whiteway11890/PIC32_Dev/README.md

# PIC32_Dev
PIC32 Development system created for Cornell University ECE 4760
