whiteway11890/PIC32_Dev/Documentation/MEng/Poster.pdf

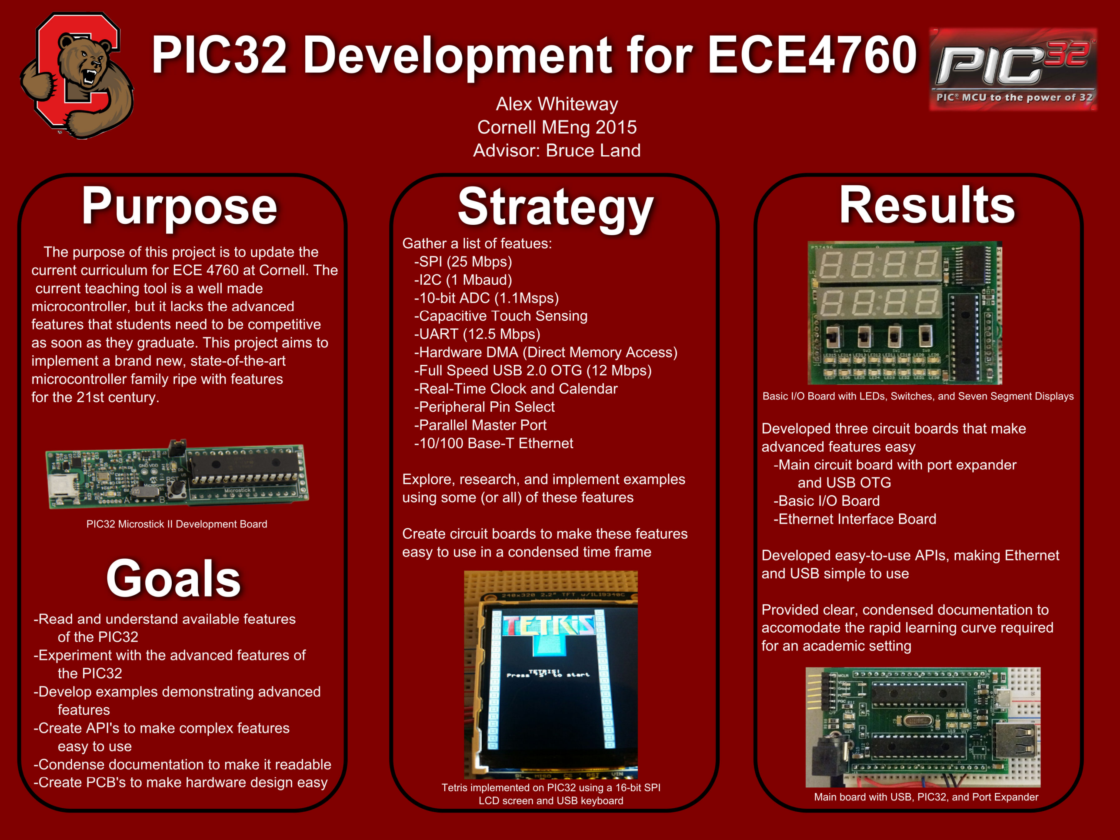
[picture p18: page 1]
