whiteway11890/PIC32_Dev/Hardware/BOM.xlsx

Part | Value | Package | Main | LED | Comm | Total | Mfr. # | Mfr | Digikey # | Digikey Link
7 Seg Display | Common Cath | DIP16 |  | 2 |  | 2 | LTC-4727JR | Lite-On | 160-1551-5-ND | http://www.digikey.com/product-detail/en/LTC-4727JR/160-1551-5-ND/408224
7 Seg Driver |  | SO24W |  | 1 |  | 1 | MAX7219CWG+T | Maxim | MAX7219CWG+TTR-ND | http://www.digikey.com/product-detail/en/MAX7219CWG%2BT/MAX7219CWG%2BTTR-ND/1514450
Barrel Plug |  | 2.1MM | 1 |  |  | 1 | RAPC722X | Switchcraft | SC1313-ND | http://www.digikey.com/product-search/en?x=0&y=0&lang=en&site=us&keywords=RAPC722X
Buckboost Conv |  | SOT-23-6 | 1 |  |  | 1 | AP1603WG-7 | Diodes Inc | AP1603WG-7DI-ND | http://www.digikey.com/product-search/en?KeyWords=AP1603WG&WT.z_header=search_go
Capacitor | 0.01uF | 1206 |  |  | 2 | 2 | CL31B103KBCNNNC | Samsung | 1276-1035-1-ND | http://www.digikey.com/product-detail/en/CL31B103KBCNNNC/1276-1035-1-ND/3889121
Capacitor | 0.1uF | 1206 | 1 | 1 |  | 2 | CL31B104KBCNNNC | Samsung | 1276-1017-1-ND | http://www.digikey.com/product-detail/en/CL31B104KBCNNNC/1276-1017-1-ND/3889103
Capacitor | 10uF | 1206 | 7 |  | 1 | 8 | CL31A106KPHNNNE | Samsung | 1276-1148-1-ND | http://www.digikey.com/product-detail/en/CL31A106KPHNNNE/1276-1148-1-ND/3889234
Capacitor | 18nF | 1206 | 2 |  | 2 | 4 | CC1206KRX7R9BB183 | Yageo | 311-1202-1-ND | http://www.digikey.com/product-detail/en/CC1206KRX7R9BB183/311-1202-1-ND/372915
Capacitor | 1uF | 1206 | 1 |  |  | 1 | CL31B105KOFNNNE | Samsung | 1276-1783-1-ND | http://www.digikey.com/product-detail/en/CL31B105KOFNNNE/1276-1783-1-ND/3889869
Capacitor | 47nF | 1206 | 1 | 1 |  | 2 | CL31B473KEHNNNE | Samsung | 1276-3172-1-ND | http://www.digikey.com/product-detail/en/CL31B473KEHNNNE/1276-3172-1-ND/3891258
Capacitor | 47uF | 1206 | 2 |  |  | 2 | CL31A476MQHNNNE | Samsung | 1276-1167-6-ND | http://www.digikey.com/product-detail/en/CL31A476MQHNNNE/1276-1167-6-ND/3891681
Capacitor | 6.8nF | 1206 |  |  | 2 | 2 | CL31B682KBCNNNC | Samsung | 1276-1775-1-ND | http://www.digikey.com/product-detail/en/CL31B682KBCNNNC/1276-1775-1-ND/3889861
Capacitor | 6.8uF | 1206 | 1 |  |  | 1 | C3216X6S1A685K085AB | TDK | 445-14757-1-ND | http://www.digikey.com/product-detail/en/C3216X6S1A685K085AB/445-14757-1-ND/3956423
Crystal | 25MHz | HC-49US |  |  | 1 | 1 | ABL-25.000MHZ-B2 | Abracon | CTX928-ND | http://www.digikey.com/product-detail/en/ATS250B-E/CTX928-ND/2292924
Crystal | 8MHz | HC-49US | 1 |  |  | 1 | ABL-8.000MHZ-B2 | Abracon | CTX900-ND | http://www.digikey.com/product-detail/en/ATS080B/CTX900-ND/2292868
Diode | Schottky 50v | SOD-123 | 1 |  |  | 1 | B0530W-7-F | Diodes Inc | B0530W-FDICT-ND | http://www.digikey.com/product-detail/en/B0530W-7-F/B0530W-FDICT-ND/815315
Eth Conn | Magjack | ZIP8 |  |  | 1 | 1 | ARJC02-111009D | Abracon | Sparkfun PRT-08534 | https://www.sparkfun.com/products/8534
Header | 1x2 | SIP2 | 2 |  |  | 2 | 961102-6404-AR | 3M | 3M9447-ND | http://www.digikey.com/product-detail/en/961102-6404-AR/3M9447-ND/2071488
Header | 1x20 | SIP20 | 2 |  |  | 2 | PRPC020SAAN-RC | Sullins | S1011EC-20-ND | http://www.digikey.com/product-detail/en/PRPC020SAAN-RC/S1011EC-20-ND/2775234
Header | 1x6 | SIP6 | 1 |  |  | 1 | 961106-5604-AR | 3M | 3M9471-ND | http://www.digikey.com/product-detail/en/961106-5604-AR/3M9471-ND/2071512
Header | 1x8 | SIP8 |  | 2 | 2 | 4 | PRPC008SFAN-RC | Sullins | S1211EC-08-ND | http://www.digikey.com/product-detail/en/PRPC008SFAN-RC/S1211EC-08-ND/2775366
Inductor | 22uH | 1206 | 1 |  |  | 1 | LQH31CN220K03L | Murata | 490-6591-1-ND | http://www.digikey.com/product-detail/en/LQH31CN220K03L/490-6591-1-ND/3845788
LED | Any color | 1206 | 6 | 17 | 1 | 24 | APTR3216SGC | Kingbright | 754-1171-1-ND | http://www.digikey.com/product-detail/en/APTR3216SGC/754-1171-1-ND/1747888
PHY/MAC |  | DIP28 |  |  | 1 | 1 | ENC28J60-I/SP | Microchip | ENC28J60-I/SP-ND | http://www.digikey.com/product-search/en?pv1291=6302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
PIC32 | MX250F128B | DIP28 | 1 |  |  | 1 | PIC32MX250F128B-50I/SP | Microchip | PIC32MX250F128B-50I/SP-ND | http://www.digikey.com/product-detail/en/PIC32MX250F128B-50I%2FSP/PIC32MX250F128B-50I%2FSP-ND/3872973
Port Exp. | MAX6957 | DIP28 | 1 | 1 |  | 2 | MAX6957ANI+ | Maxim | MAX6957ANI+-ND | http://www.digikey.com/product-detail/en/MAX6957ANI%2B/MAX6957ANI%2B-ND/950811
Power Reg | 3.3V | SOT-223 | 1 |  |  | 1 | AZ1117EH-3.3TRG1 | Diodes Inc | AZ1117EH-3.3TRG1DICT-ND | http://www.digikey.com/product-detail/en/AZ1117EH-3.3TRG1/AZ1117EH-3.3TRG1DICT-ND/5001336
Power Reg | 5V | SOT-223 | 1 |  |  | 1 | AZ1117EH-5.0TRG1 | Diodes Inc | AZ1117EH-5.0TRG1DICT-ND | http://www.digikey.com/product-detail/en/AZ1117EH-5.0TRG1/AZ1117EH-5.0TRG1DICT-ND/5001335
Resistor | 0Ω | 1206 | 2 | 3 |  | 5 | RC3216J000CS | Samsung | 1276-3514-1-ND | http://www.digikey.com/product-detail/en/RC3216J000CS/1276-3514-1-ND/3903617
Resistor | 100kΩ | 1206 | 1 |  |  | 1 | RC3216F104CS | Samsung | 1276-5781-1-ND | http://www.digikey.com/product-detail/en/RC3216F104CS/1276-5781-1-ND/3968753
Resistor | 10kΩ | 1206 |  | 1 | 1 | 2 | RC3216F103CS | Samsung | 1276-5742-1-ND | http://www.digikey.com/product-detail/en/RC3216F103CS/1276-5742-1-ND/3968714
Resistor | 10Ω | 1206 |  |  | 1 | 1 | RC3216F100CS | Samsung | 1276-3513-2-ND | http://www.digikey.com/product-detail/en/RC3216F100CS/1276-3513-2-ND/3903521
Resistor | 180Ω | 1206 |  |  | 1 | 1 | RC3216F181CS | Samsung | 1276-5679-1-ND | http://www.digikey.com/product-detail/en/RC3216F181CS/1276-5679-1-ND/3968651
Resistor | 1kΩ | 1206 | 2 | 1 | 1 | 4 | RC3216F102CS | Samsung | 1276-5711-1-ND | http://www.digikey.com/product-detail/en/RC3216F102CS/1276-5711-1-ND/3968683
Resistor | 2.7kΩ | 1206 |  |  | 1 | 1 | RC3216F272CS | Samsung | 1276-5725-2-ND | http://www.digikey.com/product-detail/en/RC3216F272CS/1276-5725-2-ND/3966032
Resistor | 330Ω | 1206 | 2 |  | 1 | 3 | RC3216F331CS | Samsung | 1276-5690-1-ND | http://www.digikey.com/product-detail/en/RC3216F331CS/1276-5690-1-ND/3968662
Resistor | 39kΩ | 1206 | 1 | 1 |  | 2 | RC1206FR-0739KL | Yageo | 311-39.0KFRCT-ND | http://www.digikey.com/product-detail/en/RC1206FR-0739KL/311-39.0KFRCT-ND/731802
Resistor | 49.9Ω | 1206 |  |  | 4 | 4 | RC1206FR-0749R9L | Yageo | 311-49.9FRCT-ND | http://www.digikey.com/product-detail/en/RC1206FR-0749R9L/311-49.9FRCT-ND/731889
Switches | Off-Mom SPST | 6.2mmx6.2mm | 1 |  |  | 1 | KSC741G LFS | C&K | CKN10305CT-ND | http://www.digikey.com/product-detail/en/KSC741G%20LFS/CKN10305CT-ND/2415036
Switches | On-Off Slide |  |  | 4 |  | 4 | OS102011MS2QN1 | C&K | CKN9565-ND | http://www.digikey.com/product-detail/en/OS102011MS2QN1/CKN9565-ND/411602
USB Pwr Sw. |  | SOIC-8 | 1 |  |  | 1 | MCP1253-33X50I/MS | Microchip | MCP1253-33X50I/MS | http://www.digikey.com/product-detail/en/MCP1253-33X50I%2FMS/MCP1253-33X50I%2FMS-ND/529833
USB-A |  | USB | 1 |  |  | 1 | UE27AC5410H | Amphenol | UE27AC5410H-ND | http://www.digikey.com/product-search/en?vendor=0&keywords=UE27AC5410H
USB-AB |  | Micro | 1 |  |  | 1 | 798-ZX62-AB-5PA11 | Hirose | H11635CT-ND | http://www.digikey.com/product-detail/en/ZX62-AB-5PA(11)/H11635CT-ND/1993370
WallWart | 5V |  | 1 |  |  | 1 | WSU060-1250 | Triad | 237-1421-ND | http://www.digikey.com/product-detail/en/WSU060-1250/237-1421-ND/3094947
