whiteway11890/PIC32_Dev/(list of files, drawings)

Other design files:
Hardware/Schematics/Communications.ms11
Hardware/Schematics/LEDs.ms11
Hardware/Schematics/Main.ms11
