whiteway11890/PIC32_Dev/Firmware/Ethernet/src/TCP.c

/*********************************************************************
 *
 *	Transmission Control Protocol (TCP) Communications Layer
 *  Module for Microchip TCP/IP Stack
 *	 -Provides reliable, handshaked transport of application stream 
 *    oriented data with flow control
 *	 -Reference: RFC 793
 *
 *********************************************************************
 * FileName:        TCP.c
 * Dependencies:    IP, Tick, Ethernet/WiFi (ENC28J60.c, ETH97J60.c, 
 *					ENCX24J600.c, or WFMac.c), ARP (optional), 
 *					DNS (optional)
 * Processor:       PIC18, PIC24F, PIC24H, dsPIC30F, dsPIC33F, PIC32
 * Compiler:        Microchip C32 v1.05 or higher
 *					Microchip C30 v3.12 or higher
 *					Microchip C18 v3.30 or higher
 *					HI-TECH PICC-18 PRO 9.63PL2 or higher
 * Company:         Microchip Technology, Inc.
 *
 * Software License Agreement
 *
 * Copyright (C) 2002-2009 Microchip Technology Inc.  All rights
 * reserved.
 *
 * Microchip licenses to you the right to use, modify, copy, and
 * distribute:
 * (i)  the Software when embedded on a Microchip microcontroller or
 *      digital signal controller product ("Device") which is
 *      integrated into Licensee's product; or
 * (ii) ONLY the Software driver source files ENC28J60.c, ENC28J60.h,
 *		ENCX24J600.c and ENCX24J600.h ported to a non-Microchip device
 *		used in conjunction with a Microchip ethernet controller for
 *		the sole purpose of interfacing with the ethernet controller.
 *
 * You should refer to the license agreement accompanying this
 * Software for additional information regarding your rights and
 * obligations.
 *
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
 *
 * Author               Date    	Comment
 *~~~~~~~~~~~~~~~~~~~~~~~~~~~~~~~~~~~~~~~~~~~~~~~~~~~~~~~~~~~~~~~~~~~~
 * Nilesh Rajbharti     5/8/01  	Original        (Rev 1.0)
 * Howard Schlunder		12/11/06	Changed almost everything to 
 *									better meet RFC 793.
 ********************************************************************/
#define __TCP_C

#include "GenericTypeDefs.h"
#include "TCPIP.h"

int tcpLoc = 0;

#if defined(STACK_USE_TCP)

/****************************************************************************
  Section:
        Configuration Parameters
 ***************************************************************************/

// Starting port for client sockets
#define LOCAL_PORT_START_NUMBER (1024u)
// End port for client sockets
#define LOCAL_PORT_END_NUMBER   (5000u)

// For debugging only.  Normal applications should never enable these
//#define DEBUG_GENERATE_TX_LOSS		62257
//#define DEBUG_GENERATE_RX_LOSS		64225

// A lot of pointer dereference code can be removed if you 
// locally copy TCBStubs to an absolute memory location.
// If you define TCP_OPTIMIZE_FOR_SIZE, local caching will 
// occur and will substantially decrease the entire TCP ROM 
// footprint (up to 35%).  If you leave TCP_OPTIMIZE_FOR_SIZE 
// undefined, the local caching will be disabled.  On PIC18 
// products, this will improve TCP performance/throughput by 
// approximately 15%.
#define TCP_OPTIMIZE_FOR_SIZE

// For smallest size and best throughput, TCP_OPTIMIZE_FOR_SIZE 
// should always be enabled on PIC24/dsPIC products.  On PIC32 
// products there is very little difference and depnds on compiler 
// optimization level
#if defined(__C30__) && !defined(TCP_OPTIMIZE_FOR_SIZE)
#define TCP_OPTIMIZE_FOR_SIZE
#elif defined(__C32__) && defined(TCP_OPTIMIZE_FOR_SIZE)
#undef TCP_OPTIMIZE_FOR_SIZE
#endif

// TCP Maximum Segment Size for TX.  The TX maximum segment size is actually 
// govered by the remote node's MSS option advirtised during connection 
// establishment.  However, if the remote node specifies an unhandlably large 
// MSS (ex: > Ethernet MTU), this define sets a hard limit so that we don't 
// cause any TX buffer overflows.  If the remote node does not advirtise a MSS 
// option, all TX segments are fixed at 536 bytes maximum.
#define TCP_MAX_SEG_SIZE_TX			(1460u)

// TCP Maximum Segment Size for RX.  This value is advirtised during connection 
// establishment and the remote node should obey it.  This should be set to 536 
// to avoid IP layer fragmentation from causing packet loss.  However, raising 
// its value can enhance performance at the (small) risk of introducing 
// incompatibility with certain special remote nodes (ex: ones connected via a 
// slow dial up modem).
#define TCP_MAX_SEG_SIZE_RX			(536u)

// TCP Timeout and retransmit numbers
#define TCP_START_TIMEOUT_VAL   	((DWORD)TICK_SECOND*1)	// Timeout to retransmit unacked data
#define TCP_DELAYED_ACK_TIMEOUT		((DWORD)TICK_SECOND/10)	// Timeout for delayed-acknowledgement algorithm
#define TCP_FIN_WAIT_2_TIMEOUT		((DWORD)TICK_SECOND*5)	// Timeout for FIN WAIT 2 state
#define TCP_KEEP_ALIVE_TIMEOUT		((DWORD)TICK_SECOND*10)	// Timeout for keep-alive messages when no traffic is sent
#define TCP_CLOSE_WAIT_TIMEOUT		((DWORD)TICK_SECOND/5)	// Timeout for the CLOSE_WAIT state
#define TCP_MAX_RETRIES			    (5u)					// Maximum number of retransmission attempts
#define TCP_MAX_UNACKED_KEEP_ALIVES	(6u)					// Maximum number of keep-alive messages that can be sent without receiving a response before automatically closing the connection
#define TCP_MAX_SYN_RETRIES			(2u)	// Smaller than all other retries to reduce SYN flood DoS duration

#define TCP_AUTO_TRANSMIT_TIMEOUT_VAL	(TICK_SECOND/25ull)	// Timeout before automatically transmitting unflushed data
#define TCP_WINDOW_UPDATE_TIMEOUT_VAL	(TICK_SECOND/5ull)	// Timeout before automatically transmitting a window update due to a TCPGet() or TCPGetArray() function call

#define TCP_SYN_QUEUE_MAX_ENTRIES	(3u) 					// Number of TCP RX SYN packets to save if they cannot be serviced immediately
#define TCP_SYN_QUEUE_TIMEOUT		((DWORD)TICK_SECOND*3)	// Timeout for when SYN queue entries are deleted if unserviceable

/****************************************************************************
  Section:
        TCP Header Data Types
 ***************************************************************************/

#define FIN     (0x01)		// FIN Flag as defined in RFC
#define SYN     (0x02)		// SYN Flag as defined in RFC
#define RST     (0x04)		// Reset Flag as defined in RFC
#define PSH     (0x08)		// Push Flag as defined in RFC
#define ACK     (0x10)		// Acknowledge Flag as defined in RFC
#define URG     (0x20)		// Urgent Flag as defined in RFC

// TCP Header Data Structure

typedef struct {
    WORD SourcePort; // Local port number
    WORD DestPort; // Remote port number
    DWORD SeqNumber; // Local sequence number
    DWORD AckNumber; // Acknowledging remote sequence number

    struct {
        unsigned char Reserved3 : 4;
        unsigned char Val : 4;
    } DataOffset; // Data offset flags nibble

    union {

        struct {
            unsigned char flagFIN : 1;
            unsigned char flagSYN : 1;
            unsigned char flagRST : 1;
            unsigned char flagPSH : 1;
            unsigned char flagACK : 1;
            unsigned char flagURG : 1;
            unsigned char Reserved2 : 2;
        } bits;
        BYTE byte;
    } Flags; // TCP Flags as defined in RFC

    WORD Window; // Local free RX buffer window
    WORD Checksum; // Data payload checksum
    WORD UrgentPointer; // Urgent pointer
} TCP_HEADER;

#define TCP_OPTIONS_END_OF_LIST     (0x00u)		// End of List TCP Option Flag
#define TCP_OPTIONS_NO_OP           (0x01u)		// No Op TCP Option
#define TCP_OPTIONS_MAX_SEG_SIZE    (0x02u)		// Maximum segment size TCP flag

typedef struct {
    BYTE Kind; // Type of option
    BYTE Length; // Length
    WORD_VAL MaxSegSize; // Maximum segment size
} TCP_OPTIONS; // TCP Options data structure

// Structure containing all the important elements of an incomming 
// SYN packet in order to establish a connection at a future time 
// if all sockets on the listening port are already connected to 
// someone

typedef struct {
    NODE_INFO niSourceAddress; // Remote IP address and MAC address
    WORD wSourcePort; // Remote TCP port number that the response SYN needs to be sent to
    DWORD dwSourceSEQ; // Remote TCP SEQuence number that must be ACKnowledged when we send our response SYN
    WORD wDestPort; // Local TCP port which the original SYN was destined for
    WORD wTimestamp; // Timer to expire old SYN packets that can't be serviced at all
} TCP_SYN_QUEUE;


#if defined(STACK_CLIENT_MODE)
static WORD NextPort __attribute__((persistent)); // Tracking variable for next local client port number
#endif

/****************************************************************************
  Section:
        TCB Definitions
 ***************************************************************************/

// Determines the number of defined TCP sockets
#define TCP_SOCKET_COUNT	(sizeof(TCPSocketInitializer)/sizeof(TCPSocketInitializer[0]))


#if defined(HI_TECH_C)
// The initializer forces this large array out of the bss section 
// so we can link correctly.
#pragma psect bigdata=TCB_uRAM_BIG
#pragma psect data=TCB_uRAM
static TCB_STUB TCBStubs[TCP_SOCKET_COUNT] = {'\0'};
#pragma psect data=ordinary_data_sect
#pragma psect bigdata=ordinary_data_sect_big
#else
// The TCB array is very large.  With the C18 compiler, one must 
// modify the linker script to make an array that spans more than 
// one memory bank.  To do this, make the necessary changes to your 
// processor's linker script (.lkr).  Here is an example showing 
// gpr11 and 128 bytes of gpr12 being combined into one 384 byte 
// block used exclusively by the TCB_uRAM data section:
// ...
// //DATABANK   NAME=gpr11      START=0xB00          END=0xBFF
// //DATABANK   NAME=gpr12      START=0xC00          END=0xCFF
// DATABANK   NAME=gpr11b     START=0xB00          END=0xC7F           PROTECTED
// DATABANK   NAME=gpr12      START=0xC80          END=0xCFF
// ...
// SECTION    NAME=TCB_uRAM    RAM=gpr11b
// ...
#if defined(__18CXX) && !defined(HI_TECH_C)	
#pragma udata TCB_uRAM
#endif
static TCB_STUB TCBStubs[TCP_SOCKET_COUNT];
#if defined(__18CXX) && !defined(HI_TECH_C)	
#pragma udata					// Return to any other RAM section
#endif
#endif

static TCB MyTCB; // Currently loaded TCB
static TCP_SOCKET hCurrentTCP = INVALID_SOCKET; // Current TCP socket
#if TCP_SYN_QUEUE_MAX_ENTRIES
#if defined(__18CXX) && !defined(HI_TECH_C)	
#pragma udata SYN_QUEUE_RAM_SECT
#endif
static TCP_SYN_QUEUE SYNQueue[TCP_SYN_QUEUE_MAX_ENTRIES]; // Array of saved incoming SYN requests that need to be serviced later
#if defined(__18CXX) && !defined(HI_TECH_C)	
#pragma udata
#endif
#endif

/****************************************************************************
  Section:
        Function Prototypes
 ***************************************************************************/

static void TCPRAMCopy(PTR_BASE wDest, BYTE vDestType, PTR_BASE wSource, BYTE vSourceType, WORD wLength);

#if defined(__18CXX)
static void TCPRAMCopyROM(PTR_BASE wDest, BYTE wDestType, ROM BYTE* wSource, WORD wLength);
#else
#define TCPRAMCopyROM(a,b,c,d)	TCPRAMCopy(a,b,c,TCP_PIC_RAM,d)
#endif

static void SendTCP(BYTE vTCPFlags, BYTE vSendFlags);
static void HandleTCPSeg(TCP_HEADER* h, WORD len);
static BOOL FindMatchingSocket(TCP_HEADER* h, NODE_INFO* remote);
static void SwapTCPHeader(TCP_HEADER* header);
static void CloseSocket(void);
static void SyncTCB(void);

// Indicates if this packet is a retransmission (no reset) or a new packet (reset required)
#define SENDTCP_RESET_TIMERS	0x01
// Instead of transmitting normal data, a garbage octet is transmitted according to RFC 1122 section 4.2.3.6
#define SENDTCP_KEEP_ALIVE		0x02


/****************************************************************************
  Section:
        TCB Optimization Configuration
 ***************************************************************************/

#if defined(TCP_OPTIMIZE_FOR_SIZE)
static TCB_STUB MyTCBStub;

// Flushes MyTCBStub cache and loads up the specified TCB_STUB.
// Does nothing on cache hit.

static void SyncTCBStub(TCP_SOCKET hTCP) {
    if (hCurrentTCP == hTCP)
        return;

    if (hCurrentTCP != INVALID_SOCKET) {
        // Save the current TCB stub
        memcpy((void*) &TCBStubs[hCurrentTCP], (void*) &MyTCBStub, sizeof (MyTCBStub));
    }

    hCurrentTCP = hTCP;

    if (hTCP == INVALID_SOCKET)
        return;

    // Load up the new TCB stub
    memcpy((void*) &MyTCBStub, (void*) &TCBStubs[hTCP], sizeof (MyTCBStub));
}
#else
// Flushes MyTCBStub cache and loads up the specified TCB_STUB.
// Does nothing on cache hit.
#define SyncTCBStub(a)	hCurrentTCP = (a)
// Alias to current TCP stub.
#define MyTCBStub		TCBStubs[hCurrentTCP]
#endif



// Flushes MyTCB cache and loads up the specified TCB.
// Does nothing on cache hit.

static void SyncTCB(void) {
    static TCP_SOCKET hLastTCB = INVALID_SOCKET;

    if (hLastTCB == hCurrentTCP)
        return;

    if (hLastTCB != INVALID_SOCKET) {
        // Save the current TCB
        TCPRAMCopy(TCBStubs[hLastTCB].bufferTxStart - sizeof (MyTCB), TCBStubs[hLastTCB].vMemoryMedium, (PTR_BASE) & MyTCB, TCP_PIC_RAM, sizeof (MyTCB));
    }

    // Load up the new TCB
    hLastTCB = hCurrentTCP;
    TCPRAMCopy((PTR_BASE) & MyTCB, TCP_PIC_RAM, MyTCBStub.bufferTxStart - sizeof (MyTCB), MyTCBStub.vMemoryMedium, sizeof (MyTCB));
}

/*****************************************************************************
  Function:
        void TCPInit(void)

  Summary:
        Initializes the TCP module.

  Description:
        Initializes the TCP module.  This function sets up the TCP buffers
        in memory and initializes each socket to the CLOSED state.  If
        insufficient memory was allocated for the TCP sockets, the function
        will hang here to be captured by the debugger.

  Precondition:
        None

  Parameters:
        None

  Returns:
        None
  	
  Remarks:
        This function is called only one during lifetime of the application.
 ***************************************************************************/
void TCPInit(void) {
    BYTE i;
    BYTE vSocketsAllocated;
    WORD wTXSize, wRXSize;
    PTR_BASE ptrBaseAddress;
    BYTE vMedium;
#if TCP_ETH_RAM_SIZE > 0
    WORD wCurrentETHAddress = TCP_ETH_RAM_BASE_ADDRESS;
#endif
#if TCP_PIC_RAM_SIZE > 0
    PTR_BASE ptrCurrentPICAddress = TCP_PIC_RAM_BASE_ADDRESS;
#endif
#if TCP_SPI_RAM_SIZE > 0
    WORD wCurrentSPIAddress = TCP_SPI_RAM_BASE_ADDRESS;
#endif

#if defined(STACK_CLIENT_MODE)
    // Initialize NextPort to a random value if it is zero (such as after
    // reset on a PIC32 or PIC18 when the static memory initializer is
    // used).  By starting with a random number, we decrease the risk of
    // reusing a port number that was previously used if the user power
    // cycles the device.
    if (NextPort == 0u)
        NextPort = (((WORD) GenerateRandomDWORD()) & 0x07FFu) + LOCAL_PORT_START_NUMBER;
#endif


    // Mark all SYN Queue entries as invalid by zeroing the memory
#if TCP_SYN_QUEUE_MAX_ENTRIES
    memset((void*) SYNQueue, 0x00, sizeof (SYNQueue));
#endif

    // Allocate all socket FIFO addresses
    vSocketsAllocated = 0;
    for (i = 0; i < TCP_SOCKET_COUNT; i++) {
        // Generate all needed sockets of each type (TCP_PURPOSE_*)
        SyncTCBStub(i);

        vMedium = TCPSocketInitializer[i].vMemoryMedium;
        wTXSize = TCPSocketInitializer[i].wTXBufferSize;
        wRXSize = TCPSocketInitializer[i].wRXBufferSize;

        switch (vMedium) {
#if TCP_ETH_RAM_SIZE > 0
            case TCP_ETH_RAM:
                ptrBaseAddress = wCurrentETHAddress;
                wCurrentETHAddress += sizeof (TCB) + wTXSize + 1 + wRXSize + 1;
                // Do a sanity check to ensure that we aren't going to use memory that hasn't been allocated to us.
                // If your code locks up right here, it means you've incorrectly allocated your TCP socket buffers in TCPIPConfig.h.  See the TCP memory allocation section.  More RAM needs to be allocated to the base memory mediums, or the individual sockets TX and RX FIFOS and socket quantiy needs to be shrunken.
                while (wCurrentETHAddress > TCP_ETH_RAM_BASE_ADDRESS + TCP_ETH_RAM_SIZE);
                break;
#endif

#if TCP_PIC_RAM_SIZE > 0
            case TCP_PIC_RAM:
                ptrBaseAddress = ptrCurrentPICAddress;
                ptrCurrentPICAddress += sizeof (TCB) + wTXSize + 1 + wRXSize + 1;
                // Do a sanity check to ensure that we aren't going to use memory that hasn't been allocated to us.
                // If your code locks up right here, it means you've incorrectly allocated your TCP socket buffers in TCPIPConfig.h.  See the TCP memory allocation section.  More RAM needs to be allocated to the base memory mediums, or the individual sockets TX and RX FIFOS and socket quantiy needs to be shrunken.
                while (ptrCurrentPICAddress > TCP_PIC_RAM_BASE_ADDRESS + TCP_PIC_RAM_SIZE);
                break;
#endif

#if TCP_SPI_RAM_SIZE > 0
            case TCP_SPI_RAM:
                ptrBaseAddress = wCurrentSPIAddress;
                wCurrentSPIAddress += sizeof (TCB) + wTXSize + 1 + wRXSize + 1;
                // Do a sanity check to ensure that we aren't going to use memory that hasn't been allocated to us.
                // If your code locks up right here, it means you've incorrectly allocated your TCP socket buffers in TCPIPConfig.h.  See the TCP memory allocation section.  More RAM needs to be allocated to the base memory mediums, or the individual sockets TX and RX FIFOS and socket quantiy needs to be shrunken.
                while (wCurrentSPIAddress > TCP_SPI_RAM_BASE_ADDRESS + TCP_SPI_RAM_SIZE);
                break;
#endif

            default:
                while (1); // Undefined allocation medium.  Go fix your TCPIPConfig.h TCP memory allocations.
        }

        MyTCBStub.vMemoryMedium = vMedium;
        MyTCBStub.bufferTxStart = ptrBaseAddress + sizeof (TCB);
        MyTCBStub.bufferRxStart = MyTCBStub.bufferTxStart + wTXSize + 1;
        MyTCBStub.bufferEnd = MyTCBStub.bufferRxStart + wRXSize;
        MyTCBStub.smState = TCP_CLOSED;
        MyTCBStub.Flags.bServer = FALSE;
#if defined(STACK_USE_SSL)
        MyTCBStub.sslStubID = SSL_INVALID_ID;
#endif		

        SyncTCB();
        MyTCB.vSocketPurpose = TCPSocketInitializer[i].vSocketPurpose;
        CloseSocket();
    }
}

/****************************************************************************
  Section:
        Connection Management Functions
 ***************************************************************************/

/*****************************************************************************
  Function:
        TCP_SOCKET TCPOpen(DWORD dwRemoteHost, BYTE vRemoteHostType, WORD wPort, BYTE vSocketPurpose)
    
  Summary:
    Opens a TCP socket for listening or as a client.

  Description:
    Provides a unified method for opening TCP sockets. This function can
    open both client and server sockets. For client sockets, it can accept
    a host name string to query in DNS, an IP address as a string, an IP
    address in binary form, or a previously resolved NODE_INFO structure
    containing the remote IP address and associated MAC address. When a
    host name or IP address only is provided, the TCP module will
    internally perform the necessary DNS and/or ARP resolution steps before
    reporting that the TCP socket is connected (via a call to
    TCPISConnected returning TRUE). Server sockets ignore this destination
    parameter and listen only on the indicated port.
    
    The vSocketPurpose field allows sockets to be opened with varying
    buffer size parameters and memory storage mediums. This field
    corresponds to pre-defined sockets allocated in the
    TCPSocketInitializer[] array in TCPIPConfig.h. The TCPIPConfig.h file
    can be edited using the TCP/IP Configuration Wizard.
    
    Sockets are statically allocated on boot, but can be claimed with this
    \function and freed using TCPDisconnect or TCPClose (for client
    sockets). Server sockets can be freed using TCPClose only (calls to
    TCPDisconnect will return server sockets to the listening state,
    allowing reuse).

  Conditions:
    TCP is initialized.

  Input:
    dwRemoteHost -     For client sockets only. Provide a pointer to a
                       null\-terminated string of the remote host name (ex\:
                       "www.microchip.com" or "192.168.1.123"), a literal
                       destination IP address (ex\: 0x7B01A8C0 or an IP_ADDR
                       data type), or a pointer to a NODE_INFO structure
                       with the remote IP address and remote node or gateway
                       MAC address specified. If a string is provided, note
                       that it must be statically allocated in memory and
                       cannot be modified or deallocated until
                       TCPIsConnected returns TRUE.<p />This parameter is
                       ignored for server sockets.
    vRemoteHostType -  Any one of the following flags to identify the
                       meaning of the dwRemoteHost parameter\:
 * TCP_OPEN_SERVER &#45; Open a server socket and
                         ignore the dwRemoteHost parameter.
 * TCP_OPEN_RAM_HOST &#45; Open a client socket and
                         connect it to a remote host who's name is stored as a
                         null terminated string in a RAM array. Ex\:
                         "www.microchip.com" or "192.168.0.123" (BYTE&#42;
                         type)
 * TCP_OPEN_ROM_HOST &#45; Open a client socket and
                         connect it to a remote host who's name is stored as a
                         null terminated string in a literal string or ROM
                         array. Ex\: "www.microchip.com" or "192.168.0.123"
                         (ROM BYTE&#42; type)
 * TCP_OPEN_IP_ADDRESS &#45; Open a client socket and
                         connect it to a remote IP address. Ex\: 0x7B01A8C0
                         for 192.168.1.123 (DWORD type). Note that the byte
                         ordering is big endian.
 * TCP_OPEN_NODE_INFO &#45; Open a client socket and
                         connect it to a remote IP and MAC addresses pair
                         stored in a NODE_INFO structure. dwRemoteHost must be
                         a pointer to the NODE_INFO structure. This option is
                         provided for backwards compatibility with
                         applications built against prior stack versions that
                         only implemented the TCPConnect() function. It can
                         also be used to skip DNS and ARP resolution steps if
                         connecting to a remote node which you've already
                         connected to and have cached addresses for.
    wPort -            TCP port to listen on or connect to\:
 * Client sockets &#45; the remote TCP port to which a
                         connection should be made. The local port for client
                         sockets will be automatically picked by the TCP
                         module.
 * Server sockets &#45; the local TCP port on which to
                         listen for connections.
    vSocketPurpose -   Any of the TCP_PURPOSE_* constants defined in
                       TCPIPConfig.h or the TCPIPConfig utility (see
                       TCPSocketInitializer[] array).

  Return Values:
    INVALID_SOCKET -  No sockets of the specified type were available to be
                      opened.
    Otherwise -       A TCP_SOCKET handle. Save this handle and use it when
                      calling all other TCP APIs.

  Remarks:
    This function replaces the old TCPConnect and TCPListen functions.
    
    If TCP_OPEN_RAM_HOST or TCP_OPEN_ROM_HOST are used for the destination
    type, the DNS client module must also be enabled (STACK_USE_DNS must be
    defined in TCPIPConfig.h).

  Example:
    \ \ 
    <code>
    // Open a server socket
    skt = TCPOpen(NULL, TCP_OPEN_SERVER, HTTP_PORT, TCP_PURPOSE_HTTP_SERVER);
    
    // Open a client socket to www.microchip.com
    // The double cast here prevents compiler warnings
    skt = TCPOpen((DWORD)(PTR_BASE)"www.microchip.com",
                    TCP_OPEN_ROM_HOST, 80, TCP_PURPOSE_DEFAULT);
    
    // Reopen a client socket without repeating DNS or ARP
    SOCKET_INFO cache = TCPGetSocketInfo(skt);  // Call with the old socket
    skt = TCPOpen((DWORD)(PTR_BASE)&amp;cache.remote, TCP_OPEN_NODE_INFO,
                    cache.remotePort.Val, TCP_PURPOSE_DEFAULT);
    </code>                                                    
 *****************************************************************************/
TCP_SOCKET TCPOpen(DWORD dwRemoteHost, BYTE vRemoteHostType, WORD wPort, BYTE vSocketPurpose) {
    TCP_SOCKET hTCP;

    // Find an available socket that matches the specified socket type
    for (hTCP = 0; hTCP < TCP_SOCKET_COUNT; hTCP++) {
        SyncTCBStub(hTCP);

        // Sockets that are in use will be in a non-closed state
        if (MyTCBStub.smState != TCP_CLOSED)
            continue;

        SyncTCB();

        // See if this socket matches the desired type
        if (MyTCB.vSocketPurpose != vSocketPurpose)
            continue;

        // Start out assuming worst case Maximum Segment Size (changes when MSS
        // option is received from remote node)
        MyTCB.wRemoteMSS = 536;

        // See if this is a server socket
        if (vRemoteHostType == TCP_OPEN_SERVER) {
            MyTCB.localPort.Val = wPort;
            MyTCBStub.Flags.bServer = TRUE;
            MyTCBStub.smState = TCP_LISTEN;
            MyTCBStub.remoteHash.Val = wPort;
#if defined(STACK_USE_SSL_SERVER)
            MyTCB.localSSLPort.Val = 0;
#endif
        }            // Handle all the client mode socket types
        else {
#if defined(STACK_CLIENT_MODE)
            {
                // Each new socket that is opened by this node, gets the
                // next sequential local port number.
                if (NextPort < LOCAL_PORT_START_NUMBER || NextPort > LOCAL_PORT_END_NUMBER)
                    NextPort = LOCAL_PORT_START_NUMBER;

                // Set the non-zero TCB fields
                MyTCB.localPort.Val = NextPort++;
                MyTCB.remotePort.Val = wPort;

                // Flag to start the DNS, ARP, SYN processes
                MyTCBStub.eventTime = TickGet();
                MyTCBStub.Flags.bTimerEnabled = 1;

                switch (vRemoteHostType) {
#if defined(STACK_USE_DNS)
                    case TCP_OPEN_RAM_HOST:
                    case TCP_OPEN_ROM_HOST:
                        MyTCB.remote.dwRemoteHost = dwRemoteHost;
                        MyTCB.flags.bRemoteHostIsROM = (vRemoteHostType == TCP_OPEN_ROM_HOST);
                        MyTCBStub.smState = TCP_GET_DNS_MODULE;
                        break;
#endif

                    case TCP_OPEN_IP_ADDRESS:
                        // dwRemoteHost is a literal IP address.  This
                        // doesn't need DNS and can skip directly to the
                        // Gateway ARPing step.
                        MyTCBStub.remoteHash.Val = (((DWORD_VAL*) & dwRemoteHost)->w[1]+((DWORD_VAL*) & dwRemoteHost)->w[0] + wPort) ^ MyTCB.localPort.Val;
                        MyTCB.remote.niRemoteMACIP.IPAddr.Val = dwRemoteHost;
                        MyTCB.retryCount = 0;
                        MyTCB.retryInterval = (TICK_SECOND / 4) / 256;
                        MyTCBStub.smState = TCP_GATEWAY_SEND_ARP;
                        break;

                    case TCP_OPEN_NODE_INFO:
                        MyTCBStub.remoteHash.Val = (((NODE_INFO*) (PTR_BASE) dwRemoteHost)->IPAddr.w[1]+((NODE_INFO*) (PTR_BASE) dwRemoteHost)->IPAddr.w[0] + wPort) ^ MyTCB.localPort.Val;
                        memcpy((void*) (BYTE*) & MyTCB.remote, (void*) (BYTE*) (PTR_BASE) dwRemoteHost, sizeof (NODE_INFO));
                        MyTCBStub.smState = TCP_SYN_SENT;
                        SendTCP(SYN, SENDTCP_RESET_TIMERS);
                        break;
                }
            }
#else
            {
                return INVALID_SOCKET;
            }
#endif
        }

        return hTCP;
    }

    // If there is no socket available, return error.
    return INVALID_SOCKET;
}

/*****************************************************************************
  Function:
        BOOL TCPWasReset(TCP_SOCKET hTCP)

  Summary:
        Self-clearing semaphore inidicating socket reset.

  Description:
        This function is a self-clearing semaphore indicating whether or not
        a socket has been disconnected since the previous call.  This function
        works for all possible disconnections: a call to TCPDisconnect, a FIN
        from the remote node, or an acknowledgement timeout caused by the loss
        of a network link.  It also returns TRUE after the first call to TCPInit.
        Applications should use this function to reset their state machines.
	
        This function was added due to the possibility of an error when relying
        on TCPIsConnected returing FALSE to check for a condition requiring a
        state machine reset.  If a socket is closed (due to a FIN ACK) and then
        immediately reopened (due to a the arrival of a new SYN) in the same
        cycle of the stack, calls to TCPIsConnected by the application will
        never return FALSE even though the socket has been disconnected.  This
        can cause errors for protocols such as HTTP in which a client will
        immediately open a new connection upon closing of a prior one.  Relying
        on this function instead allows applications to trap those conditions
        and properly reset their internal state for the new connection.

  Precondition:
        TCP is initialized.

  Parameters:
        hTCP - The socket to check.

  Return Values:
        TRUE - The socket has been disconnected since the previous call.
        FALSE - The socket has not been disconnected since the previous call.
 ***************************************************************************/
BOOL TCPWasReset(TCP_SOCKET hTCP) {
    if (hTCP >= TCP_SOCKET_COUNT) {
        return TRUE;
    }

    SyncTCBStub(hTCP);

    if (MyTCBStub.Flags.bSocketReset) {
        MyTCBStub.Flags.bSocketReset = 0;
        return TRUE;
    }

    return FALSE;
}

/*****************************************************************************
  Function:
        BOOL TCPIsConnected(TCP_SOCKET hTCP)

  Summary:
        Determines if a socket has an established connection.

  Description:
        This function determines if a socket has an established connection to
        a remote node.  Call this function after calling TCPOpen to determine
        when the connection is set up and ready for use.  This function was
        historically used to check for disconnections, but TCPWasReset is now a
        more appropriate solution.

  Precondition:
        TCP is initialized.

  Parameters:
        hTCP - The socket to check.

  Return Values:
        TRUE - The socket has an established connection to a remote node.
        FALSE - The socket is not currently connected.

  Remarks:
        A socket is said to be connected only if it is in the TCP_ESTABLISHED
        state.  Sockets in the process of opening or closing will return FALSE.
 ***************************************************************************/
BOOL TCPIsConnected(TCP_SOCKET hTCP) {
    if (hTCP >= TCP_SOCKET_COUNT) {
        return FALSE;
    }

    SyncTCBStub(hTCP);
    return (MyTCBStub.smState == TCP_ESTABLISHED);
}

/*****************************************************************************
  Function:
        void TCPDisconnect(TCP_SOCKET hTCP)

  Summary:
        Disconnects an open socket.

  Description:
        This function closes a connection to a remote node by sending a FIN (if
        currently connected).
	
        The function can be called a second time to force a socket closed by
        sending a RST packet.  This is useful when the application knows that
        the remote node will not send an ACK (if it has crashed or lost its link),
        or when the application needs to reuse the socket immediately regardless
        of whether or not the remote node would like to transmit more data before
        closing.
	
        For client mode sockets, upon return, the hTCP handle is relinquished to
        the TCP/IP stack and must no longer be used by the application (except for
        an immediate subsequent call to TCPDisconnect() to force a RST
        transmission, if needed).
	
        For server mode sockets, upon return, the hTCP handle is NOT relinquished
        to the TCP/IP stack.  After closing, the socket returns to the listening
        state allowing future connection requests to be serviced.  This leaves the
        hTCP handle in a valid state and must be retained for future operations on
        the socket.  If you want to close the server and relinquish the socket back
        to the TCP/IP stack, call the TCPClose() API instead of TCPDisconnect().

  Precondition:
        None

  Parameters:
        hTCP - Handle of the socket to disconnect.

  Returns:
        None

  Remarks:
        If the socket is using SSL, a CLOSE_NOTIFY record will be transmitted
        first to allow the SSL session to be resumed at a later time.
 ***************************************************************************/
void TCPDisconnect(TCP_SOCKET hTCP) {
    if (hTCP >= TCP_SOCKET_COUNT) {
        return;
    }

    SyncTCBStub(hTCP);

    // Delete all data in the RX FIFO
    // In this stack's API, the application TCP handle is
    // immediately invalid after calling this function, so there
    // is no longer any way to receive data from the TCP RX FIFO,
    // even though the data is still there.  Leaving the data there
    // could interfere with the remote node sending us a FIN if our
    // RX window is zero
    MyTCBStub.rxTail = MyTCBStub.rxHead;

    switch (MyTCBStub.smState) {
#if defined(STACK_CLIENT_MODE) && defined(STACK_USE_DNS)
        case TCP_DNS_RESOLVE:
            DNSEndUsage(); // Release the DNS module, since the user is aborting
            CloseSocket();
            break;
#endif

        case TCP_GET_DNS_MODULE:
        case TCP_GATEWAY_SEND_ARP:
        case TCP_GATEWAY_GET_ARP:
        case TCP_SYN_SENT:
            CloseSocket();
            break;

        case TCP_SYN_RECEIVED:
        case TCP_ESTABLISHED:
#if defined(STACK_USE_SSL)
            // When disconnecting SSL sockets, send a close_notify so we can resume later
            if (MyTCBStub.sslStubID != SSL_INVALID_ID) {
                // Flush pending data and send close_notify
                SSLTxRecord(hTCP, MyTCBStub.sslStubID, SSL_APPLICATION);
                SSLTxMessage(hTCP, MyTCBStub.sslStubID, SSL_ALERT_CLOSE_NOTIFY);
            }
#endif

            // Send the FIN.  This is done in a loop to ensure that if we have
            // more data wating in the TX FIFO than can be sent in a single
            // packet (due to the remote Max Segment Size packet size limit),
            // we will keep generating more packets until either all data gets
            // transmitted or the remote node's receive window fills up.
            do {
                SendTCP(FIN | ACK, SENDTCP_RESET_TIMERS);
                if (MyTCB.remoteWindow == 0u)
                    break;
            } while (MyTCBStub.txHead != MyTCB.txUnackedTail);

            MyTCBStub.smState = TCP_FIN_WAIT_1;
            break;

        case TCP_CLOSE_WAIT:
            // Send the FIN.  This is done in a loop to ensure that if we have
            // more data wating in the TX FIFO than can be sent in a single
            // packet (due to the remote Max Segment Size packet size limit),
            // we will keep generating more packets until either all data gets
            // transmitted or the remote node's receive window fills up.
            do {
                SendTCP(FIN | ACK, SENDTCP_RESET_TIMERS);
                if (MyTCB.remoteWindow == 0u)
                    break;
            } while (MyTCBStub.txHead != MyTCB.txUnackedTail);

            MyTCBStub.smState = TCP_LAST_ACK;
            break;

            // These states are all already closed or don't need explicit disconnecting -- they will disconnect by themselves after a while
            //case TCP_CLOSED:
            //case TCP_LISTEN:
            //case TCP_CLOSING:
            //case TCP_TIME_WAIT:
            //	return;

        case TCP_CLOSED_BUT_RESERVED:
            MyTCBStub.smState = TCP_CLOSED;
            break;

            // These states will close themselves after some delay, however,
            // this is handled so that the user can call TCPDisconnect()
            // twice to immediately close a socket (using an RST) without
            // having to get an ACK back from the remote node.  This is
            // great for instance when the application determines that
            // the remote node has been physically disconnected and
            // already knows that no ACK will be returned.  Alternatively,
            // if the application needs to immediately reuse the socket
            // regardless of what the other node's state is in (half open).
        case TCP_FIN_WAIT_1:
        case TCP_FIN_WAIT_2:
        case TCP_LAST_ACK:
        default:
            SendTCP(RST | ACK, 0);
            CloseSocket();
            break;
    }
}

/*****************************************************************************
  Function:
        void TCPClose(TCP_SOCKET hTCP)

  Summary:
        Disconnects an open socket and destroys the socket handle, including server
        mode socket handles.

  Description:
        Disconnects an open socket and destroys the socket handle, including server
        mode socket handles.  This function performs identically to the
        TCPDisconnect() function, except that both client and server mode socket
        handles are relinquished to the TCP/IP stack upon return.

  Precondition:
        None

  Parameters:
        hTCP - Handle to the socket to disconnect and close.

  Returns:
        None
 ***************************************************************************/
void TCPClose(TCP_SOCKET hTCP) {
    if (hTCP >= TCP_SOCKET_COUNT) {
        return;
    }

    SyncTCBStub(hTCP);
    MyTCBStub.Flags.bServer = FALSE;
    TCPDisconnect(hTCP);
}

/*****************************************************************************
  Function:
        SOCKET_INFO* TCPGetRemoteInfo(TCP_SOCKET hTCP)

  Summary:
        Obtains information about a currently open socket.

  Description:
        Returns the SOCKET_INFO structure associated with this socket.  This
        contains the NODE_INFO structure with IP and MAC address (or gateway
        MAC) and the remote port.

  Precondition:
        TCP is initialized and the socket is connected.

  Parameters:
        hTCP - The socket to check.

  Returns:
        The SOCKET_INFO structure associated with this socket.  This structure is
        allocated statically by the function and is valid only until the next
        time TCPGetRemoteInfo() is called.
 ***************************************************************************/
SOCKET_INFO* TCPGetRemoteInfo(TCP_SOCKET hTCP) {
    static SOCKET_INFO RemoteInfo;

    if (hTCP >= TCP_SOCKET_COUNT) {
        return 0;
    }

    SyncTCBStub(hTCP);
    SyncTCB();
    memcpy((void*) &RemoteInfo.remote, (void*) &MyTCB.remote, sizeof (NODE_INFO));
    RemoteInfo.remotePort.Val = MyTCB.remotePort.Val;

    return &RemoteInfo;
}



/****************************************************************************
  Section:
        Transmit Functions
 ***************************************************************************/

/*****************************************************************************
  Function:
        void TCPFlush(TCP_SOCKET hTCP)

  Summary:
        Immediately transmits all pending TX data.

  Description:
        This function immediately transmits all pending TX data with a PSH
        flag.  If this function is not called, data will automatically be sent
        when either a) the TX buffer is half full or b) the
        TCP_AUTO_TRANSMIT_TIMEOUT_VAL (default: 40ms) has elapsed.

  Precondition:
        TCP is initialized and the socket is connected.

  Parameters:
        hTCP - The socket whose data is to be transmitted.

  Returns:
        None

  Remarks:
        SSL application data is automatically flushed, so this function has
        no effect for SSL sockets.
 ***************************************************************************/
void TCPFlush(TCP_SOCKET hTCP) {
    if (hTCP >= TCP_SOCKET_COUNT) {
        return;
    }

    SyncTCBStub(hTCP);
    SyncTCB();

    // NOTE: Pending SSL data will NOT be transferred here

    if (MyTCBStub.txHead != MyTCB.txUnackedTail) {
        // Send the TCP segment with all unacked bytes
        SendTCP(ACK, SENDTCP_RESET_TIMERS);
    }
}

/*****************************************************************************
  Function:
        WORD TCPIsPutReady(TCP_SOCKET hTCP)

  Summary:
        Determines how much free space is available in the TCP TX buffer.

  Description:
        Call this function to determine how many bytes can be written to the
        TCP TX buffer.  If this function returns zero, the application must
        return to the main stack loop before continuing in order to transmit
        more data.

  Precondition:
        TCP is initialized.

  Parameters:
        hTCP - The socket to check.

  Returns:
        The number of bytes available to be written in the TCP TX buffer.
 ***************************************************************************/
WORD TCPIsPutReady(TCP_SOCKET hTCP) {
    BYTE i;

    if (hTCP >= TCP_SOCKET_COUNT) {
        return 0;
    }

    SyncTCBStub(hTCP);

    i = MyTCBStub.smState;

    // Unconnected sockets shouldn't be transmitting anything.
    if (!((i == (BYTE) TCP_ESTABLISHED) || (i == (BYTE) TCP_CLOSE_WAIT)))
        return 0;

    // Calculate the free space in this socket's TX FIFO
#if defined(STACK_USE_SSL)
    if (MyTCBStub.sslStubID != SSL_INVALID_ID) {// Use sslTxHead as the head pointer when SSL is active
        WORD rem;

        // Find out raw free space
        if (MyTCBStub.sslTxHead >= MyTCBStub.txTail)
            rem = (MyTCBStub.bufferRxStart - MyTCBStub.bufferTxStart - 1) - (MyTCBStub.sslTxHead - MyTCBStub.txTail);
        else
            rem = MyTCBStub.txTail - MyTCBStub.sslTxHead - 1;

        // Reserve space for a new MAC and header
        if (rem > 22u)
            return rem - 22;
        else
            return 0;
    }
#endif

    if (MyTCBStub.txHead >= MyTCBStub.txTail)
        return (MyTCBStub.bufferRxStart - MyTCBStub.bufferTxStart - 1) - (MyTCBStub.txHead - MyTCBStub.txTail);
    else
        return MyTCBStub.txTail - MyTCBStub.txHead - 1;
}

/*****************************************************************************
  Function:
        BOOL TCPPut(TCP_SOCKET hTCP, BYTE byte)

  Description:
        Writes a single byte to a TCP socket.

  Precondition:
        TCP is initialized.

  Parameters:
        hTCP - The socket to which data is to be written.
        byte - The byte to write.

  Return Values:
        TRUE - The byte was written to the transmit buffer.
        FALSE - The transmit buffer was full, or the socket is not connected.
 ***************************************************************************/
BOOL TCPPut(TCP_SOCKET hTCP, BYTE byte) {
    WORD wFreeTXSpace;

    if (hTCP >= TCP_SOCKET_COUNT) {
        return 0;
    }

    SyncTCBStub(hTCP);

    wFreeTXSpace = TCPIsPutReady(hTCP);
    if (wFreeTXSpace == 0u)
        return FALSE;
    else if (wFreeTXSpace == 1u) // About to run out of space, lets transmit so the remote node might send an ACK back faster
        TCPFlush(hTCP);

    // Send all current bytes if we are crossing half full
    // This is required to improve performance with the delayed
    // acknowledgement algorithm
    if ((!MyTCBStub.Flags.bHalfFullFlush) && (wFreeTXSpace <= ((MyTCBStub.bufferRxStart - MyTCBStub.bufferTxStart) >> 1))) {
        TCPFlush(hTCP);
        MyTCBStub.Flags.bHalfFullFlush = TRUE;
    }

#if defined(STACK_USE_SSL)
    if (MyTCBStub.sslStubID != SSL_INVALID_ID) {
        TCPRAMCopy(MyTCBStub.sslTxHead, MyTCBStub.vMemoryMedium, (PTR_BASE) & byte, TCP_PIC_RAM, sizeof (byte));
        if (++MyTCBStub.sslTxHead >= MyTCBStub.bufferRxStart)
            MyTCBStub.sslTxHead = MyTCBStub.bufferTxStart;
    } else {
        TCPRAMCopy(MyTCBStub.txHead, MyTCBStub.vMemoryMedium, (PTR_BASE) & byte, TCP_PIC_RAM, sizeof (byte));
        if (++MyTCBStub.txHead >= MyTCBStub.bufferRxStart)
            MyTCBStub.txHead = MyTCBStub.bufferTxStart;
    }
#else
    TCPRAMCopy(MyTCBStub.txHead, MyTCBStub.vMemoryMedium, (PTR_BASE) & byte, TCP_PIC_RAM, sizeof (byte));
    if (++MyTCBStub.txHead >= MyTCBStub.bufferRxStart)
        MyTCBStub.txHead = MyTCBStub.bufferTxStart;
#endif


    // Send the last byte as a separate packet (likely will make the remote node send back ACK faster)
    if (wFreeTXSpace == 1u) {
        TCPFlush(hTCP);
    }        // If not already enabled, start a timer so this data will
        // eventually get sent even if the application doens't call
        // TCPFlush()
    else if (!MyTCBStub.Flags.bTimer2Enabled) {
        MyTCBStub.Flags.bTimer2Enabled = TRUE;
        MyTCBStub.eventTime2 = (WORD) TickGetDiv256() + TCP_AUTO_TRANSMIT_TIMEOUT_VAL / 256ull;
    }

    return TRUE;
}

/*****************************************************************************
  Function:
        WORD TCPPutArray(TCP_SOCKET hTCP, BYTE* data, WORD len)

  Description:
        Writes an array from RAM to a TCP socket.

  Precondition:
        TCP is initialized.

  Parameters:
        hTCP - The socket to which data is to be written.
        data - Pointer to the array to be written.
        len  - Number of bytes to be written.

  Returns:
        The number of bytes written to the socket.  If less than len, the
        buffer became full or the socket is not conected.
 ***************************************************************************/
WORD TCPPutArray(TCP_SOCKET hTCP, BYTE* data, WORD len) {
    WORD wActualLen;
    WORD wFreeTXSpace;
    WORD wRightLen = 0;

    if (hTCP >= TCP_SOCKET_COUNT) {
        return 0;
    }

    SyncTCBStub(hTCP);

    wFreeTXSpace = TCPIsPutReady(hTCP);
    if (wFreeTXSpace == 0u) {
        TCPFlush(hTCP);
        return 0;
    }

    wActualLen = wFreeTXSpace;
    if (wFreeTXSpace > len)
        wActualLen = len;

    // Send all current bytes if we are crossing half full
    // This is required to improve performance with the delayed
    // acknowledgement algorithm
    if ((!MyTCBStub.Flags.bHalfFullFlush) && (wFreeTXSpace <= ((MyTCBStub.bufferRxStart - MyTCBStub.bufferTxStart) >> 1))) {
        TCPFlush(hTCP);
        MyTCBStub.Flags.bHalfFullFlush = TRUE;
    }

#if defined(STACK_USE_SSL)
    if (MyTCBStub.sslStubID != SSL_INVALID_ID) {
        // See if we need a two part put
        if (MyTCBStub.sslTxHead + wActualLen >= MyTCBStub.bufferRxStart) {
            wRightLen = MyTCBStub.bufferRxStart - MyTCBStub.sslTxHead;
            TCPRAMCopy(MyTCBStub.sslTxHead, MyTCBStub.vMemoryMedium, (PTR_BASE) data, TCP_PIC_RAM, wRightLen);
            data += wRightLen;
            wActualLen -= wRightLen;
            MyTCBStub.sslTxHead = MyTCBStub.bufferTxStart;
        }

        TCPRAMCopy(MyTCBStub.sslTxHead, MyTCBStub.vMemoryMedium, (PTR_BASE) data, TCP_PIC_RAM, wActualLen);
        MyTCBStub.sslTxHead += wActualLen;
    } else {
        // See if we need a two part put
        if (MyTCBStub.txHead + wActualLen >= MyTCBStub.bufferRxStart) {
            wRightLen = MyTCBStub.bufferRxStart - MyTCBStub.txHead;
            TCPRAMCopy(MyTCBStub.txHead, MyTCBStub.vMemoryMedium, (PTR_BASE) data, TCP_PIC_RAM, wRightLen);
            data += wRightLen;
            wActualLen -= wRightLen;
            MyTCBStub.txHead = MyTCBStub.bufferTxStart;
        }

        TCPRAMCopy(MyTCBStub.txHead, MyTCBStub.vMemoryMedium, (PTR_BASE) data, TCP_PIC_RAM, wActualLen);
        MyTCBStub.txHead += wActualLen;
    }
#else
    // See if we need a two part put
    if (MyTCBStub.txHead + wActualLen >= MyTCBStub.bufferRxStart) {
        wRightLen = MyTCBStub.bufferRxStart - MyTCBStub.txHead;
        TCPRAMCopy(MyTCBStub.txHead, MyTCBStub.vMemoryMedium, (PTR_BASE) data, TCP_PIC_RAM, wRightLen);
        data += wRightLen;
        wActualLen -= wRightLen;
        MyTCBStub.txHead = MyTCBStub.bufferTxStart;
    }

    TCPRAMCopy(MyTCBStub.txHead, MyTCBStub.vMemoryMedium, (PTR_BASE) data, TCP_PIC_RAM, wActualLen);
    MyTCBStub.txHead += wActualLen;
#endif

    // Send these bytes right now if we are out of TX buffer space
    if (wFreeTXSpace <= len) {
        TCPFlush(hTCP);
    }        // If not already enabled, start a timer so this data will
        // eventually get sent even if the application doens't call
        // TCPFlush()
    else if (!MyTCBStub.Flags.bTimer2Enabled) {
        MyTCBStub.Flags.bTimer2Enabled = TRUE;
        MyTCBStub.eventTime2 = (WORD) TickGetDiv256() + TCP_AUTO_TRANSMIT_TIMEOUT_VAL / 256ull;
    }

    return wActualLen + wRightLen;
}

/*****************************************************************************
  Function:
        WORD TCPPutROMArray(TCP_SOCKET hTCP, ROM BYTE* data, WORD len)

  Description:
        Writes an array from ROM to a TCP socket.

  Precondition:
        TCP is initialized.

  Parameters:
        hTCP - The socket to which data is to be written.
        data - Pointer to the array to be written.
        len  - Number of bytes to be written.

  Returns:
        The number of bytes written to the socket.  If less than len, the
        buffer became full or the socket is not conected.

  Remarks:
        This function is aliased to TCPPutArray on non-PIC18 platforms.
 ***************************************************************************/
#if defined(__18CXX)

WORD TCPPutROMArray(TCP_SOCKET hTCP, ROM BYTE* data, WORD len) {
    WORD wActualLen;
    WORD wFreeTXSpace;
    WORD wRightLen = 0;

    if (hTCP >= TCP_SOCKET_COUNT) {
        return 0;
    }

    SyncTCBStub(hTCP);

    wFreeTXSpace = TCPIsPutReady(hTCP);
    if (wFreeTXSpace == 0u) {
        TCPFlush(hTCP);
        return 0;
    }

    // Send all current bytes if we are crossing half full
    // This is required to improve performance with the delayed
    // acknowledgement algorithm
    if ((!MyTCBStub.Flags.bHalfFullFlush) && (wFreeTXSpace <= ((MyTCBStub.bufferRxStart - MyTCBStub.bufferTxStart) >> 1))) {
        TCPFlush(hTCP);
        MyTCBStub.Flags.bHalfFullFlush = TRUE;
    }

    wActualLen = wFreeTXSpace;
    if (wFreeTXSpace > len)
        wActualLen = len;

#if defined(STACK_USE_SSL)
    if (MyTCBStub.sslStubID != SSL_INVALID_ID) {
        // See if we need a two part put
        if (MyTCBStub.sslTxHead + wActualLen >= MyTCBStub.bufferRxStart) {
            wRightLen = MyTCBStub.bufferRxStart - MyTCBStub.sslTxHead;
            TCPRAMCopyROM(MyTCBStub.sslTxHead, MyTCBStub.vMemoryMedium, data, wRightLen);
            data += wRightLen;
            wActualLen -= wRightLen;
            MyTCBStub.sslTxHead = MyTCBStub.bufferTxStart;
        }

        TCPRAMCopyROM(MyTCBStub.sslTxHead, MyTCBStub.vMemoryMedium, data, wActualLen);
        MyTCBStub.sslTxHead += wActualLen;
    } else {
        // See if we need a two part put
        if (MyTCBStub.txHead + wActualLen >= MyTCBStub.bufferRxStart) {
            wRightLen = MyTCBStub.bufferRxStart - MyTCBStub.txHead;
            TCPRAMCopyROM(MyTCBStub.txHead, MyTCBStub.vMemoryMedium, data, wRightLen);
            data += wRightLen;
            wActualLen -= wRightLen;
            MyTCBStub.txHead = MyTCBStub.bufferTxStart;
        }

        TCPRAMCopyROM(MyTCBStub.txHead, MyTCBStub.vMemoryMedium, data, wActualLen);
        MyTCBStub.txHead += wActualLen;
    }
#else
    // See if we need a two part put
    if (MyTCBStub.txHead + wActualLen >= MyTCBStub.bufferRxStart) {
        wRightLen = MyTCBStub.bufferRxStart - MyTCBStub.txHead;
        TCPRAMCopyROM(MyTCBStub.txHead, MyTCBStub.vMemoryMedium, data, wRightLen);
        data += wRightLen;
        wActualLen -= wRightLen;
        MyTCBStub.txHead = MyTCBStub.bufferTxStart;
    }

    TCPRAMCopyROM(MyTCBStub.txHead, MyTCBStub.vMemoryMedium, data, wActualLen);
    MyTCBStub.txHead += wActualLen;
#endif

    // Send these bytes right now if we are out of TX buffer space
    if (wFreeTXSpace <= len) {
        TCPFlush(hTCP);
    }        // If not already enabled, start a timer so this data will
        // eventually get sent even if the application doens't call
        // TCPFlush()
    else if (!MyTCBStub.Flags.bTimer2Enabled) {
        MyTCBStub.Flags.bTimer2Enabled = TRUE;
        MyTCBStub.eventTime2 = (WORD) TickGetDiv256() + TCP_AUTO_TRANSMIT_TIMEOUT_VAL / 256ull;
    }

    return wActualLen + wRightLen;
}
#endif

/*****************************************************************************
  Function:
        BYTE* TCPPutString(TCP_SOCKET hTCP, BYTE* data)

  Description:
        Writes a null-terminated string from RAM to a TCP socket.  The
        null-terminator is not copied to the socket.

  Precondition:
        TCP is initialized.

  Parameters:
        hTCP - The socket to which data is to be written.
        data - Pointer to the string to be written.

  Returns:
        Pointer to the byte following the last byte written to the socket.  If
        this pointer does not dereference to a NUL byte, the buffer became full
        or the socket is not connected.

  Remarks:
        The return value of this function differs from that of TCPPutArray.  To
        write long strings in a single state, initialize the *data pointer to the
        first byte, then call this function repeatedly (breaking to the main
        stack loop after each call) until the return value dereferences to a NUL
        byte.  Save the return value as the new starting *data pointer otherwise.
 ***************************************************************************/
BYTE* TCPPutString(TCP_SOCKET hTCP, BYTE* data) {
    return data + TCPPutArray(hTCP, data, strlen((char*) data));
}

/*****************************************************************************
  Function:
        BYTE* TCPPutROMString(TCP_SOCKET hTCP, ROM BYTE* data)

  Description:
        Writes a null-terminated string from ROM to a TCP socket.  The
        null-terminator is not copied to the socket.

  Precondition:
        TCP is initialized.

  Parameters:
        hTCP - The socket to which data is to be written.
        data - Pointer to the string to be written.

  Returns:
        Pointer to the byte following the last byte written to the socket.  If
        this pointer does not dereference to a NUL byte, the buffer became full
        or the socket is not connected.

  Remarks:
        The return value of this function differs from that of TCPPutArray.  To
        write long strings in a single state, initialize the *data pointer to the
        first byte, then call this function repeatedly (breaking to the main
        stack loop after each call) until the return value dereferences to a NUL
        byte.  Save the return value as the new starting *data pointer otherwise.
	
        This function is aliased to TCPPutString on non-PIC18 platforms.
 ***************************************************************************/
#if defined(__18CXX)

ROM BYTE* TCPPutROMString(TCP_SOCKET hTCP, ROM BYTE* data) {
    return data + TCPPutROMArray(hTCP, data, strlenpgm((ROM char*) data));
}
#endif

/*****************************************************************************
  Function:
        WORD TCPGetTxFIFOFull(TCP_SOCKET hTCP)

  Description:
        Determines how many bytes are pending in the TCP TX FIFO.

  Precondition:
        TCP is initialized.

  Parameters:
        hTCP - The socket to check.

  Returns:
        Number of bytes pending to be flushed in the TCP TX FIFO.
 ***************************************************************************/
WORD TCPGetTxFIFOFull(TCP_SOCKET hTCP) {
    WORD wDataLen;
    WORD wFIFOSize;

    if (hTCP >= TCP_SOCKET_COUNT) {
        return 0;
    }

    SyncTCBStub(hTCP);

    // Calculate total usable FIFO size
    wFIFOSize = MyTCBStub.bufferRxStart - MyTCBStub.bufferTxStart - 1;

    // Find out how many data bytes are free in the TX FIFO
    wDataLen = TCPIsPutReady(hTCP);

    return wFIFOSize - wDataLen;
}



/****************************************************************************
  Section:
        Receive Functions
 ***************************************************************************/

/*****************************************************************************
  Function:
        void TCPDiscard(TCP_SOCKET hTCP)

  Description:
        Discards any pending data in the TCP RX FIFO.

  Precondition:
        TCP is initialized.

  Parameters:
        hTCP - The socket whose RX FIFO is to be cleared.

  Returns:
        None
 ***************************************************************************/
void TCPDiscard(TCP_SOCKET hTCP) {
    if (TCPIsGetReady(hTCP)) {
        SyncTCBStub(hTCP);

        // Delete all data in the RX buffer
        MyTCBStub.rxTail = MyTCBStub.rxHead;

        // Send a Window update message to the remote node
        SendTCP(ACK, SENDTCP_RESET_TIMERS);
    }
}

/*****************************************************************************
  Function:
        void WORD TCPIsGetReady(TCP_SOCKET hTCP)

  Summary:
        Determines how many bytes can be read from the TCP RX buffer.

  Description:
        Call this function to determine how many bytes can be read from the
        TCP RX buffer.  If this function returns zero, the application must
        return to the main stack loop before continuing in order to wait for
        more data to arrive.

  Precondition:
        TCP is initialized.

  Parameters:
        hTCP - The socket to check.

  Returns:
        The number of bytes available to be read from the TCP RX buffer.
 ***************************************************************************/
WORD TCPIsGetReady(TCP_SOCKET hTCP) {
    if (hTCP >= TCP_SOCKET_COUNT) {
        return 0;
    }

    SyncTCBStub(hTCP);

    if (MyTCBStub.rxHead >= MyTCBStub.rxTail)
        return MyTCBStub.rxHead - MyTCBStub.rxTail;
    else
        return (MyTCBStub.bufferEnd - MyTCBStub.rxTail + 1) + (MyTCBStub.rxHead - MyTCBStub.bufferRxStart);
}

/*****************************************************************************
  Function:
        BOOL TCPGet(TCP_SOCKET hTCP, BYTE* byte)

  Description:
        Retrieves a single byte to a TCP socket.

  Precondition:
        TCP is initialized.

  Parameters:
        hTCP - The socket from which to read.
        byte - Pointer to location in which the read byte should be stored.

  Return Values:
        TRUE - A byte was read from the buffer.
        FALSE - The buffer was empty, or the socket is not connected.
 ***************************************************************************/
BOOL TCPGet(TCP_SOCKET hTCP, BYTE* byte) {
    WORD wGetReadyCount;

    // See if there is any data which can be read
    wGetReadyCount = TCPIsGetReady(hTCP);
    if (wGetReadyCount == 0u)
        return FALSE;

    SyncTCBStub(hTCP);

    if (byte)
        TCPRAMCopy((PTR_BASE) byte, TCP_PIC_RAM, MyTCBStub.rxTail, MyTCBStub.vMemoryMedium, 1);
    if (++MyTCBStub.rxTail > MyTCBStub.bufferEnd)
        MyTCBStub.rxTail = MyTCBStub.bufferRxStart;

    // Send a window update if we've run out of data
    if (wGetReadyCount == 1u) {
        MyTCBStub.Flags.bTXASAPWithoutTimerReset = 1;
    }        // If not already enabled, start a timer so a window
        // update will get sent to the remote node at some point
    else if (!MyTCBStub.Flags.bTimer2Enabled) {
        MyTCBStub.Flags.bTimer2Enabled = TRUE;
        MyTCBStub.eventTime2 = (WORD) TickGetDiv256() + TCP_WINDOW_UPDATE_TIMEOUT_VAL / 256ull;
    }


    return TRUE;
}

/*****************************************************************************
  Function:
        WORD TCPGetArray(TCP_SOCKET hTCP, BYTE* buffer, WORD len)

  Description:
        Reads an array of data bytes from a TCP socket's receive FIFO.  The data
        is removed from the FIFO in the process.

  Precondition:
        TCP is initialized.

  Parameters:
        hTCP - The socket from which data is to be read.
        buffer - Pointer to the array to store data that was read.
        len  - Number of bytes to be read.

  Returns:
        The number of bytes read from the socket.  If less than len, the
        RX FIFO buffer became empty or the socket is not conected.
 ***************************************************************************/
WORD TCPGetArray(TCP_SOCKET hTCP, BYTE* buffer, WORD len) {
    WORD wGetReadyCount;
    WORD RightLen = 0;

    // See if there is any data which can be read
    wGetReadyCount = TCPIsGetReady(hTCP);
    if (wGetReadyCount == 0u)
        return 0x0000u;

    SyncTCBStub(hTCP);

    // Make sure we don't try to read more data than is available
    if (len > wGetReadyCount)
        len = wGetReadyCount;

    // See if we need a two part get
    if (MyTCBStub.rxTail + len > MyTCBStub.bufferEnd) {
        RightLen = MyTCBStub.bufferEnd - MyTCBStub.rxTail + 1;
        if (buffer) {
            TCPRAMCopy((PTR_BASE) buffer, TCP_PIC_RAM, MyTCBStub.rxTail, MyTCBStub.vMemoryMedium, RightLen);
            buffer += RightLen;
        }
        len -= RightLen;
        MyTCBStub.rxTail = MyTCBStub.bufferRxStart;
    }

    if (buffer)
        TCPRAMCopy((PTR_BASE) buffer, TCP_PIC_RAM, MyTCBStub.rxTail, MyTCBStub.vMemoryMedium, len);
    MyTCBStub.rxTail += len;
    len += RightLen;

    // Send a window update if we've run low on data
    if (wGetReadyCount - len <= len) {
        MyTCBStub.Flags.bTXASAPWithoutTimerReset = 1;
    } else if (!MyTCBStub.Flags.bTimer2Enabled)
        // If not already enabled, start a timer so a window
        // update will get sent to the remote node at some point
    {
        MyTCBStub.Flags.bTimer2Enabled = TRUE;
        MyTCBStub.eventTime2 = (WORD) TickGetDiv256() + TCP_WINDOW_UPDATE_TIMEOUT_VAL / 256ull;
    }

    return len;
}

/*****************************************************************************
  Function:
        WORD TCPGetRxFIFOFree(TCP_SOCKET hTCP)

  Description:
        Determines how many bytes are free in the RX FIFO.

  Precondition:
        TCP is initialized.

  Parameters:
        hTCP - The socket to check.

  Returns:
        The number of bytes free in the TCP RX FIFO.  If zero, no additional
        data can be received until the application removes some data using one
        of the TCPGet family functions.
 ***************************************************************************/
WORD TCPGetRxFIFOFree(TCP_SOCKET hTCP) {
    WORD wDataLen;
    WORD wFIFOSize;

    if (hTCP >= TCP_SOCKET_COUNT) {
        return 0;
    }

    SyncTCBStub(hTCP);

    // Calculate total usable FIFO size
    wFIFOSize = MyTCBStub.bufferEnd - MyTCBStub.bufferRxStart;

#if defined(STACK_USE_SSL)
    {
        PTR_BASE SSLtemp = MyTCBStub.rxHead;

        // Move SSL pointer to determine full buffer size
        if (MyTCBStub.sslStubID != SSL_INVALID_ID)
            MyTCBStub.rxHead = MyTCBStub.sslRxHead;

        // Find out how many data bytes are actually in the RX FIFO
        wDataLen = TCPIsGetReady(hTCP);

        // Move SSL pointer back to proper location (if we changed it)
        MyTCBStub.rxHead = SSLtemp;
    }
#else
    {
        // Find out how many data bytes are actually in the RX FIFO
        wDataLen = TCPIsGetReady(hTCP);
    }
#endif

    // Perform the calculation
    return wFIFOSize - wDataLen;
}

/*****************************************************************************
  Function:
        WORD TCPPeekArray(TCP_SOCKET hTCP, BYTE *vBuffer, WORD wLen, WORD wStart)

  Summary:
        Reads a specified number of data bytes from the TCP RX FIFO without
        removing them from the buffer.

  Description:
        Reads a specified number of data bytes from the TCP RX FIFO without
        removing them from the buffer.  No TCP control actions are taken as a
        result of this function (ex: no window update is sent to the remote node).
  	
  Precondition:
        TCP is initialized.

  Parameters:
        hTCP - The socket to peak from (read without removing from stream).
        vBuffer - Destination to write the peeked data bytes.
        wLen - Length of bytes to peak from the RX FIFO and copy to vBuffer.
        wStart - Zero-indexed starting position within the FIFO to start peeking
                from.

  Return Values:
        Number of bytes actually peeked from the stream and copied to vBuffer.
        This value can be less than wLen if wStart + wLen is greater than the
        deepest possible character in the RX FIFO.

  Remarks:
        None
 ***************************************************************************/
WORD TCPPeekArray(TCP_SOCKET hTCP, BYTE *vBuffer, WORD wLen, WORD wStart) {
    PTR_BASE ptrRead;
    WORD w;
    WORD wBytesUntilWrap;

    if (hTCP >= TCP_SOCKET_COUNT || wLen == 0) {
        return 0;
    }

    SyncTCBStub(hTCP);

    // Find out how many bytes are in the RX FIFO and decrease read length
    // if the start offset + read length is beyond the end of the FIFO
    w = TCPIsGetReady(hTCP);
    if (wStart + wLen > w)
        wLen = w - wStart;

    // Find the read start location
    ptrRead = MyTCBStub.rxTail + wStart;
    if (ptrRead > MyTCBStub.bufferEnd)
        ptrRead -= MyTCBStub.bufferEnd - MyTCBStub.bufferRxStart + 1;

    // Calculate how many bytes can be read in a single go
    wBytesUntilWrap = MyTCBStub.bufferEnd - ptrRead + 1;
    if (wLen <= wBytesUntilWrap) {
        // Read all at once
        TCPRAMCopy((PTR_BASE) vBuffer, TCP_PIC_RAM, ptrRead, MyTCBStub.vMemoryMedium, wLen);
    } else {
        // Read all bytes up to the wrap position and then read remaining bytes
        // at the start of the buffer
        TCPRAMCopy((PTR_BASE) vBuffer, TCP_PIC_RAM, ptrRead, MyTCBStub.vMemoryMedium, wBytesUntilWrap);
        TCPRAMCopy((PTR_BASE) vBuffer + wBytesUntilWrap, TCP_PIC_RAM, MyTCBStub.bufferRxStart, MyTCBStub.vMemoryMedium, wLen - wBytesUntilWrap);
    }

    return wLen;
}

/*****************************************************************************
  Function:
        BYTE TCPPeek(TCP_SOCKET hTCP, WORD wStart)

  Summary:
        Peaks at one byte in the TCP RX FIFO without removing it from the buffer.

  Description:
        Peaks at one byte in the TCP RX FIFO without removing it from the buffer.
  	
  Precondition:
        TCP is initialized.

  Parameters:
        hTCP - The socket to peak from (read without removing from stream).
        wStart - Zero-indexed starting position within the FIFO to peek from.

  Return Values:
        Byte peeked from the RX FIFO.  If there is no data in the buffer or an
        illegal wStart starting offset is given, then an indeterminate value is
        returned.  The caller must ensure that valid parameters are passed to avoid
        (i.e ensure that TCPIsGetReady() returns a number that is less than wStart
        before calling TCPPeek()).

  Remarks:
        Use the TCPPeekArray() function to read more than one byte.  It will
        perform better than calling TCPPeek() in a loop.
 ***************************************************************************/
BYTE TCPPeek(TCP_SOCKET hTCP, WORD wStart) {
    BYTE i;

    TCPPeekArray(hTCP, &i, 1, wStart);
    return i;
}


/****************************************************************************
  Section:
        Search Functions
 ***************************************************************************/

/*****************************************************************************
  Function:
        WORD TCPFindArrayEx(TCP_SOCKET hTCP, BYTE* cFindArray, WORD wLen,
                                                WORD wStart, WORD wSearchLen, BOOL bTextCompare)

  Summary:
        Searches for a string in the TCP RX buffer.

  Description:
        This function finds the first occurrance of an array of bytes in the
        TCP RX buffer.  It can be used by an application to abstract searches
        out of their own application code.  For increased efficiency, the
        function is capable of limiting the scope of search to a specific
        range of bytes.  It can also perform a case-insensitive search if
        required.
	
        For example, if the buffer contains "I love PIC MCUs!" and the search
        array is "love" with a length of 4, a value of 2 will be returned.

  Precondition:
        TCP is initialized.

  Parameters:
        hTCP - The socket to search within.
        cFindArray - The array of bytes to find in the buffer.
        wLen - Length of cFindArray.
        wStart - Zero-indexed starting position within the buffer.
        wSearchLen - Length from wStart to search in the buffer.
        bTextCompare - TRUE for case-insensitive text search, FALSE for binary search

  Return Values:
        0xFFFF - Search array not found
        Otherwise - Zero-indexed position of the first occurrance

  Remarks:
        Since this function usually must transfer data from external storage
        to internal RAM for comparison, its performance degrades significantly
        when the buffer is full and the array is not found.  For better
        performance, try to search for characters that are expected to exist or
        limit the scope of the search as much as possible.  The HTTP2 module,
        for example, uses this function to parse headers.  However, it searches
        for newlines, then the separating colon, then reads the header name to
        RAM for final comparison.  This has proven to be significantly faster
        than searching for full header name strings outright.
 ***************************************************************************/
WORD TCPFindArrayEx(TCP_SOCKET hTCP, BYTE* cFindArray, WORD wLen, WORD wStart, WORD wSearchLen, BOOL bTextCompare) {
    PTR_BASE ptrRead;
    WORD wDataLen;
    WORD wBytesUntilWrap;
    PTR_BASE ptrLocation;
    WORD wLenStart;
    BYTE *cFindArrayStart;
    BYTE i, j, k;
    BOOL isFinding;
    BYTE buffer[32];

    if (hTCP >= TCP_SOCKET_COUNT || wLen == 0) {
        return 0;
    }

    SyncTCBStub(hTCP);

    // Find out how many bytes are in the RX FIFO and return
    // immediately if we won't possibly find a match
    wDataLen = TCPIsGetReady(hTCP) - wStart;
    if (wDataLen < wLen)
        return 0xFFFFu;
    if (wSearchLen && (wDataLen > wSearchLen))
        wDataLen = wSearchLen;

    ptrLocation = MyTCBStub.rxTail + wStart;
    if (ptrLocation > MyTCBStub.bufferEnd)
        ptrLocation -= MyTCBStub.bufferEnd - MyTCBStub.bufferRxStart + 1;
    ptrRead = ptrLocation;
    wBytesUntilWrap = MyTCBStub.bufferEnd - ptrLocation + 1;
    ptrLocation = wStart;
    wLenStart = wLen;
    cFindArrayStart = cFindArray;
    j = *cFindArray++;
    isFinding = FALSE;
    if (bTextCompare) {
        if (j >= 'a' && j <= 'z')
            j += 'A' - 'a';
    }

    // Search for the array
    while (1) {
        // Figure out how big of a chunk to read
        k = sizeof (buffer);
        if (k > wBytesUntilWrap)
            k = wBytesUntilWrap;
        if ((WORD) k > wDataLen)
            k = wDataLen;

        // Read a chunk of data into the buffer
        TCPRAMCopy((PTR_BASE) buffer, TCP_PIC_RAM, ptrRead, MyTCBStub.vMemoryMedium, (WORD) k);
        ptrRead += k;
        wBytesUntilWrap -= k;

        if (wBytesUntilWrap == 0u) {
            ptrRead = MyTCBStub.bufferRxStart;
            wBytesUntilWrap = 0xFFFFu;
        }

        // Convert everything to uppercase
        if (bTextCompare) {
            for (i = 0; i < k; i++) {
                if (buffer[i] >= 'a' && buffer[i] <= 'z')
                    buffer[i] += 'A' - 'a';

                if (j == buffer[i]) {
                    if (--wLen == 0u)
                        return ptrLocation - wLenStart + i + 1;
                    j = *cFindArray++;
                    isFinding = TRUE;
                    if (j >= 'a' && j <= 'z')
                        j += 'A' - 'a';
                } else {
                    wLen = wLenStart;
                    if (isFinding) {
                        cFindArray = cFindArrayStart;
                        j = *cFindArray++;
                        if (j >= 'a' && j <= 'z')
                            j += 'A' - 'a';
                        isFinding = FALSE;
                    }
                }
            }
        } else // Compare as is
        {
            for (i = 0; i < k; i++) {
                if (j == buffer[i]) {
                    if (--wLen == 0u)
                        return ptrLocation - wLenStart + i + 1;
                    j = *cFindArray++;
                    isFinding = TRUE;
                } else {
                    wLen = wLenStart;
                    if (isFinding) {
                        cFindArray = cFindArrayStart;
                        j = *cFindArray++;
                        isFinding = FALSE;
                    }
                }
            }
        }

        // Check to see if it is impossible to find a match
        wDataLen -= k;
        if (wDataLen < wLen)
            return 0xFFFFu;

        ptrLocation += k;
    }
}

/*****************************************************************************
  Function:
        WORD TCPFindROMArrayEx(TCP_SOCKET hTCP, BYTE* cFindArray, WORD wLen,
                                                WORD wStart, WORD wSearchLen, BOOL bTextCompare)

  Summary:
        Searches for a ROM string in the TCP RX buffer.

  Description:
        This function finds the first occurrance of an array of bytes in the
        TCP RX buffer.  It can be used by an application to abstract searches
        out of their own application code.  For increased efficiency, the
        function is capable of limiting the scope of search to a specific
        range of bytes.  It can also perform a case-insensitive search if
        required.
	
        For example, if the buffer contains "I love PIC MCUs!" and the search
        array is "love" with a length of 4, a value of 2 will be returned.

  Precondition:
        TCP is initialized.

  Parameters:
        hTCP - The socket to search within.
        cFindArray - The array of bytes to find in the buffer.
        wLen - Length of cFindArray.
        wStart - Zero-indexed starting position within the buffer.
        wSearchLen - Length from wStart to search in the buffer.
        bTextCompare - TRUE for case-insensitive text search, FALSE for binary search

  Return Values:
        0xFFFF - Search array not found
        Otherwise - Zero-indexed position of the first occurrance

  Remarks:
        Since this function usually must transfer data from external storage
        to internal RAM for comparison, its performance degrades significantly
        when the buffer is full and the array is not found.  For better
        performance, try to search for characters that are expected to exist or
        limit the scope of the search as much as possible.  The HTTP2 module,
        for example, uses this function to parse headers.  However, it searches
        for newlines, then the separating colon, then reads the header name to
        RAM for final comparison.  This has proven to be significantly faster
        than searching for full header name strings outright.
	
        This function is aliased to TCPFindArrayEx on non-PIC18 platforms.
 ***************************************************************************/
#if defined(__18CXX)

WORD TCPFindROMArrayEx(TCP_SOCKET hTCP, ROM BYTE* cFindArray, WORD wLen, WORD wStart, WORD wSearchLen, BOOL bTextCompare) {
    PTR_BASE ptrRead;
    WORD wDataLen;
    WORD wBytesUntilWrap;
    PTR_BASE ptrLocation;
    WORD wLenStart;
    ROM BYTE *cFindArrayStart;
    BYTE i, j, k;
    BOOL isFinding;
    BYTE buffer[32];

    if (hTCP >= TCP_SOCKET_COUNT || wLen == 0) {
        return 0;
    }

    SyncTCBStub(hTCP);

    // Find out how many bytes are in the RX FIFO and return
    // immediately if we won't possibly find a match
    wDataLen = TCPIsGetReady(hTCP) - wStart;
    if (wDataLen < wLen)
        return 0xFFFFu;
    if (wSearchLen && (wDataLen > wSearchLen))
        wDataLen = wSearchLen;

    ptrLocation = MyTCBStub.rxTail + wStart;
    if (ptrLocation > MyTCBStub.bufferEnd)
        ptrLocation -= MyTCBStub.bufferEnd - MyTCBStub.bufferRxStart + 1;
    ptrRead = ptrLocation;
    wBytesUntilWrap = MyTCBStub.bufferEnd - ptrLocation + 1;
    ptrLocation = wStart;
    wLenStart = wLen;
    cFindArrayStart = cFindArray;
    j = *cFindArray++;
    isFinding = FALSE;
    if (bTextCompare) {
        if (j >= 'a' && j <= 'z')
            j += 'A' - 'a';
    }

    // Search for the array
    while (1) {
        // Figure out how big of a chunk to read
        k = sizeof (buffer);
        if (k > wBytesUntilWrap)
            k = wBytesUntilWrap;
        if ((WORD) k > wDataLen)
            k = wDataLen;

        // Read a chunk of data into the buffer
        TCPRAMCopy((PTR_BASE) buffer, TCP_PIC_RAM, ptrRead, MyTCBStub.vMemoryMedium, (WORD) k);
        ptrRead += k;
        wBytesUntilWrap -= k;

        if (wBytesUntilWrap == 0u) {
            ptrRead = MyTCBStub.bufferRxStart;
            wBytesUntilWrap = 0xFFFFu;
        }

        // Convert everything to uppercase
        if (bTextCompare) {
            for (i = 0; i < k; i++) {
                if (buffer[i] >= 'a' && buffer[i] <= 'z')
                    buffer[i] += 'A' - 'a';

                if (j == buffer[i]) {
                    if (--wLen == 0u)
                        return ptrLocation - wLenStart + i + 1;
                    j = *cFindArray++;
                    isFinding = TRUE;
                    if (j >= 'a' && j <= 'z')
                        j += 'A' - 'a';
                } else {
                    wLen = wLenStart;
                    if (isFinding) {
                        cFindArray = cFindArrayStart;
                        j = *cFindArray++;
                        if (j >= 'a' && j <= 'z')
                            j += 'A' - 'a';
                        isFinding = FALSE;
                    }
                }
            }
        } else // Compare as is
        {
            for (i = 0; i < k; i++) {
                if (j == buffer[i]) {
                    if (--wLen == 0u)
                        return ptrLocation - wLenStart + i + 1;
                    j = *cFindArray++;
                    isFinding = TRUE;
                } else {
                    wLen = wLenStart;
                    if (isFinding) {
                        cFindArray = cFindArrayStart;
                        j = *cFindArray++;
                        isFinding = FALSE;
                    }
                }
            }
        }

        // Check to see if it is impossible to find a match
        wDataLen -= k;
        if (wDataLen < wLen)
            return 0xFFFFu;

        ptrLocation += k;
    }
}
#endif

/*****************************************************************************
  Function:
        WORD TCPFindEx(TCP_SOCKET hTCP, BYTE cFind,
                                                WORD wStart, WORD wSearchLen, BOOL bTextCompare)

  Summary:
        Searches for a byte in the TCP RX buffer.

  Description:
        This function finds the first occurrance of a byte in the TCP RX
        buffer.  It can be used by an application to abstract searches
        out of their own application code.  For increased efficiency, the
        function is capable of limiting the scope of search to a specific
        range of bytes.  It can also perform a case-insensitive search if
        required.
	
        For example, if the buffer contains "I love PIC MCUs!" and the cFind
        byte is ' ', a value of 1 will be returned.

  Precondition:
        TCP is initialized.

  Parameters:
        hTCP - The socket to search within.
        cFind - The byte to find in the buffer.
        wStart - Zero-indexed starting position within the buffer.
        wSearchLen - Length from wStart to search in the buffer.
        bTextCompare - TRUE for case-insensitive text search, FALSE for binary search

  Return Values:
        0xFFFF - Search array not found
        Otherwise - Zero-indexed position of the first occurrance

  Remarks:
        Since this function usually must transfer data from external storage
        to internal RAM for comparison, its performance degrades significantly
        when the buffer is full and the array is not found.  For better
        performance, try to search for characters that are expected to exist or
        limit the scope of the search as much as possible.  The HTTP2 module,
        for example, uses this function to parse headers.  However, it searches
        for newlines, then the separating colon, then reads the header name to
        RAM for final comparison.  This has proven to be significantly faster
        than searching for full header name strings outright.
 ***************************************************************************/
WORD TCPFindEx(TCP_SOCKET hTCP, BYTE cFind, WORD wStart, WORD wSearchLen, BOOL bTextCompare) {
    return TCPFindArrayEx(hTCP, &cFind, sizeof (cFind), wStart, wSearchLen, bTextCompare);
}



/****************************************************************************
  Section:
        Data Processing Functions
 ***************************************************************************/

/*****************************************************************************
  Function:
        void TCPTick(void)

  Summary:
        Performs periodic TCP tasks.

  Description:
        This function performs any required periodic TCP tasks.  Each
        socket's state machine is checked, and any elapsed timeout periods
        are handled.

  Precondition:
        TCP is initialized.

  Parameters:
        None

  Returns:
        None
 ***************************************************************************/
void TCPTick(void) {
    TCP_SOCKET hTCP;
    BOOL bRetransmit;
    BOOL bCloseSocket;
    BYTE vFlags;
    WORD w;

    // Periodically all "not closed" sockets must perform timed operations
    for (hTCP = 0; hTCP < TCP_SOCKET_COUNT; hTCP++) {
        SyncTCBStub(hTCP);

        // Handle any SSL Processing and Message Transmission
#if defined(STACK_USE_SSL)
        if (MyTCBStub.sslStubID != SSL_INVALID_ID) {
            // Handle any periodic tasks, such as RSA operations
            SSLPeriodic(hTCP, MyTCBStub.sslStubID);

            // If unsent data is waiting, transmit it as an application record
            if (MyTCBStub.sslTxHead != MyTCBStub.txHead && TCPSSLGetPendingTxSize(hTCP) != 0u)
                SSLTxRecord(hTCP, MyTCBStub.sslStubID, SSL_APPLICATION);

            // If an SSL message is requested, send it now
            if (MyTCBStub.sslReqMessage != SSL_NO_MESSAGE)
                SSLTxMessage(hTCP, MyTCBStub.sslStubID, MyTCBStub.sslReqMessage);
        }
#endif

        vFlags = 0x00;
        bRetransmit = FALSE;
        bCloseSocket = FALSE;

        // Transmit ASAP data if the medium is available
        if (MyTCBStub.Flags.bTXASAP || MyTCBStub.Flags.bTXASAPWithoutTimerReset) {
            if (MACIsTxReady()) {
                vFlags = ACK;
                bRetransmit = MyTCBStub.Flags.bTXASAPWithoutTimerReset;
            }
        }

        // Perform any needed window updates and data transmissions
        if (MyTCBStub.Flags.bTimer2Enabled) {
            // See if the timeout has occured, and we need to send a new window update and pending data
            if ((SHORT) (MyTCBStub.eventTime2 - (WORD) TickGetDiv256()) <= (SHORT) 0)
                vFlags = ACK;
        }

        // Process Delayed ACKnowledgement timer
        if (MyTCBStub.Flags.bDelayedACKTimerEnabled) {
            // See if the timeout has occured and delayed ACK needs to be sent
            if ((SHORT) (MyTCBStub.OverlappedTimers.delayedACKTime - (WORD) TickGetDiv256()) <= (SHORT) 0)
                vFlags = ACK;
        }

        // Process TCP_CLOSE_WAIT timer
        if (MyTCBStub.smState == TCP_CLOSE_WAIT) {
            // Automatically close the socket on our end if the application
            // fails to call TCPDisconnect() is a reasonable amount of time.
            if ((SHORT) (MyTCBStub.OverlappedTimers.closeWaitTime - (WORD) TickGetDiv256()) <= (SHORT) 0) {
                vFlags = FIN | ACK;
                MyTCBStub.smState = TCP_LAST_ACK;
            }
        }

        // Process listening server sockets that might have a SYN waiting in the SYNQueue[]
#if TCP_SYN_QUEUE_MAX_ENTRIES
        if (MyTCBStub.smState == TCP_LISTEN) {
            for (w = 0; w < TCP_SYN_QUEUE_MAX_ENTRIES; w++) {
                // Abort search if there are no more valid records
                if (SYNQueue[w].wDestPort == 0u)
                    break;

                // Stop searching if this SYN queue entry can be used by this socket
#if defined(STACK_USE_SSL_SERVER)
                if (SYNQueue[w].wDestPort == MyTCBStub.remoteHash.Val || SYNQueue[w].wDestPort == MyTCBStub.sslTxHead)
#else
                if (SYNQueue[w].wDestPort == MyTCBStub.remoteHash.Val)
#endif
                {
                    // Set up our socket and generate a reponse SYN+ACK packet
                    SyncTCB();

#if defined(STACK_USE_SSL_SERVER)
                    // If this matches the SSL port, make sure that can be configured
                    // before continuing.  If not, break and leave this in the queue
                    if (SYNQueue[w].wDestPort == MyTCBStub.sslTxHead && !TCPStartSSLServer(hTCP))
                        break;
#endif

                    memcpy((void*) &MyTCB.remote.niRemoteMACIP, (void*) &SYNQueue[w].niSourceAddress, sizeof (NODE_INFO));
                    MyTCB.remotePort.Val = SYNQueue[w].wSourcePort;
                    MyTCB.RemoteSEQ = SYNQueue[w].dwSourceSEQ + 1;
                    MyTCBStub.remoteHash.Val = (MyTCB.remote.niRemoteMACIP.IPAddr.w[1] + MyTCB.remote.niRemoteMACIP.IPAddr.w[0] + MyTCB.remotePort.Val) ^ MyTCB.localPort.Val;
                    vFlags = SYN | ACK;
                    MyTCBStub.smState = TCP_SYN_RECEIVED;

                    // Delete this SYN from the SYNQueue and compact the SYNQueue[] array
                    TCPRAMCopy((PTR_BASE) & SYNQueue[w], TCP_PIC_RAM, (PTR_BASE) & SYNQueue[w + 1], TCP_PIC_RAM, (TCP_SYN_QUEUE_MAX_ENTRIES - 1u - w) * sizeof (TCP_SYN_QUEUE));
                    SYNQueue[TCP_SYN_QUEUE_MAX_ENTRIES - 1].wDestPort = 0u;

                    break;
                }
            }
        }
#endif

        if (vFlags)
            SendTCP(vFlags, bRetransmit ? 0 : SENDTCP_RESET_TIMERS);

        // The TCP_CLOSED, TCP_LISTEN, and sometimes the TCP_ESTABLISHED
        // state don't need any timeout events, so see if the timer is enabled
        if (!MyTCBStub.Flags.bTimerEnabled) {
#if defined(TCP_KEEP_ALIVE_TIMEOUT)
            // Only the established state has any use for keep-alives
            if (MyTCBStub.smState == TCP_ESTABLISHED) {
                // If timeout has not occured, do not do anything.
                if ((LONG) (TickGet() - MyTCBStub.eventTime) < (LONG) 0)
                    continue;

                // If timeout has occured and the connection appears to be dead (no
                // responses from remote node at all), close the connection so the
                // application doesn't sit around indefinitely with a useless socket
                // that it thinks is still open
                if (MyTCBStub.Flags.vUnackedKeepalives == TCP_MAX_UNACKED_KEEP_ALIVES) {
                    vFlags = MyTCBStub.Flags.bServer;

                    // Force an immediate FIN and RST transmission
                    // Double calling TCPDisconnect() will also place us
                    // back in the listening state immediately if a server socket.
                    TCPDisconnect(hTCP);
                    TCPDisconnect(hTCP);

                    // Prevent client mode sockets from getting reused by other applications.
                    // The application must call TCPDisconnect() with the handle to free this
                    // socket (and the handle associated with it)
                    if (!vFlags)
                        MyTCBStub.smState = TCP_CLOSED_BUT_RESERVED;

                    continue;
                }

                // Otherwise, if a timeout occured, simply send a keep-alive packet
                SyncTCB();
                SendTCP(ACK, SENDTCP_KEEP_ALIVE);
                MyTCBStub.eventTime = TickGet() + TCP_KEEP_ALIVE_TIMEOUT;
            }
#endif
            continue;
        }

        // If timeout has not occured, do not do anything.
        if ((LONG) (TickGet() - MyTCBStub.eventTime) < (LONG) 0)
            continue;

        // Load up extended TCB information
        SyncTCB();

        // A timeout has occured.  Respond to this timeout condition
        // depending on what state this socket is in.
        switch (MyTCBStub.smState) {
#if defined(STACK_CLIENT_MODE)
#if defined(STACK_USE_DNS)
            case TCP_GET_DNS_MODULE:
                if (DNSBeginUsage()) {
                    MyTCBStub.smState = TCP_DNS_RESOLVE;
                    if (MyTCB.flags.bRemoteHostIsROM)
                        DNSResolveROM((ROM BYTE*) (ROM_PTR_BASE) MyTCB.remote.dwRemoteHost, DNS_TYPE_A);
                    else
                        DNSResolve((BYTE*) (PTR_BASE) MyTCB.remote.dwRemoteHost, DNS_TYPE_A);
                }
                break;

            case TCP_DNS_RESOLVE:
            {
                IP_ADDR ipResolvedDNSIP;

                // See if DNS resolution has finished.  Note that if the DNS
                // fails, the &ipResolvedDNSIP will be written with 0x00000000.
                // MyTCB.remote.dwRemoteHost is unioned with
                // MyTCB.remote.niRemoteMACIP.IPAddr, so we can't directly write
                // the DNS result into MyTCB.remote.niRemoteMACIP.IPAddr.  We
                // must copy it over only if the DNS is resolution step was
                // successful.
                if (DNSIsResolved(&ipResolvedDNSIP)) {
                    if (DNSEndUsage()) {
                        MyTCB.remote.niRemoteMACIP.IPAddr.Val = ipResolvedDNSIP.Val;
                        MyTCBStub.smState = TCP_GATEWAY_SEND_ARP;
                        MyTCBStub.remoteHash.Val = (MyTCB.remote.niRemoteMACIP.IPAddr.w[1] + MyTCB.remote.niRemoteMACIP.IPAddr.w[0] + MyTCB.remotePort.Val) ^ MyTCB.localPort.Val;
                        MyTCB.retryCount = 0;
                        MyTCB.retryInterval = (TICK_SECOND / 4) / 256;
                    } else {
                        MyTCBStub.eventTime = TickGet() + 10 * TICK_SECOND;
                        MyTCBStub.smState = TCP_GET_DNS_MODULE;
                    }
                }
                break;
            }
#endif // #if defined(STACK_USE_DNS)

            case TCP_GATEWAY_SEND_ARP:
                // Obtain the MAC address associated with the server's IP address (either direct MAC address on same subnet, or the MAC address of the Gateway machine)
                MyTCBStub.eventTime2 = (WORD) TickGetDiv256();
                ARPResolve(&MyTCB.remote.niRemoteMACIP.IPAddr);
                MyTCBStub.smState = TCP_GATEWAY_GET_ARP;
                break;

            case TCP_GATEWAY_GET_ARP:
                // Wait for the MAC address to finish being obtained
                if (!ARPIsResolved(&MyTCB.remote.niRemoteMACIP.IPAddr, &MyTCB.remote.niRemoteMACIP.MACAddr)) {
                    // Time out if too much time is spent in this state
                    // Note that this will continuously send out ARP
                    // requests for an infinite time if the Gateway
                    // never responds
                    if ((WORD) TickGetDiv256() - MyTCBStub.eventTime2 > (WORD) MyTCB.retryInterval) {
                        // Exponentially increase timeout until we reach 6 attempts then stay constant
                        if (MyTCB.retryCount < 6u) {
                            MyTCB.retryCount++;
                            MyTCB.retryInterval <<= 1;
                        }

                        // Retransmit ARP request
                        MyTCBStub.smState = TCP_GATEWAY_SEND_ARP;
                    }
                    break;
                }

                // Send out SYN connection request to remote node
                // This automatically disables the Timer from
                // continuously firing for this socket
                vFlags = SYN;
                bRetransmit = FALSE;
                MyTCBStub.smState = TCP_SYN_SENT;
                break;
#endif // #if defined(STACK_CLIENT_MODE)

            case TCP_SYN_SENT:
                // Keep sending SYN until we hear from remote node.
                // This may be for infinite time, in that case
                // caller must detect it and do something.
                vFlags = SYN;
                bRetransmit = TRUE;

                // Exponentially increase timeout until we reach TCP_MAX_RETRIES attempts then stay constant
                if (MyTCB.retryCount >= (TCP_MAX_RETRIES - 1)) {
                    MyTCB.retryCount = TCP_MAX_RETRIES - 1;
                    MyTCB.retryInterval = TCP_START_TIMEOUT_VAL << (TCP_MAX_RETRIES - 1);
                }
                break;

            case TCP_SYN_RECEIVED:
                // We must receive ACK before timeout expires.
                // If not, resend SYN+ACK.
                // Abort, if maximum attempts counts are reached.
                if (MyTCB.retryCount < TCP_MAX_SYN_RETRIES) {
                    vFlags = SYN | ACK;
                    bRetransmit = TRUE;
                } else {
                    if (MyTCBStub.Flags.bServer) {
                        vFlags = RST | ACK;
                        bCloseSocket = TRUE;
                    } else {
                        vFlags = SYN;
                    }
                }
                break;

            case TCP_ESTABLISHED:
            case TCP_CLOSE_WAIT:
                // Retransmit any unacknowledged data
                if (MyTCB.retryCount < TCP_MAX_RETRIES) {
                    vFlags = ACK;
                    bRetransmit = TRUE;
                } else {
                    // No response back for too long, close connection
                    // This could happen, for instance, if the communication
                    // medium was lost
                    MyTCBStub.smState = TCP_FIN_WAIT_1;
                    vFlags = FIN | ACK;
                }
                break;

            case TCP_FIN_WAIT_1:
                if (MyTCB.retryCount < TCP_MAX_RETRIES) {
                    // Send another FIN
                    vFlags = FIN | ACK;
                    bRetransmit = TRUE;
                } else {
                    // Close on our own, we can't seem to communicate
                    // with the remote node anymore
                    vFlags = RST | ACK;
                    bCloseSocket = TRUE;
                }
                break;

            case TCP_FIN_WAIT_2:
                // Close on our own, we can't seem to communicate
                // with the remote node anymore
                vFlags = RST | ACK;
                bCloseSocket = TRUE;
                break;

            case TCP_CLOSING:
                if (MyTCB.retryCount < TCP_MAX_RETRIES) {
                    // Send another ACK+FIN (the FIN is retransmitted
                    // automatically since it hasn't been acknowledged by
                    // the remote node yet)
                    vFlags = ACK;
                    bRetransmit = TRUE;
                } else {
                    // Close on our own, we can't seem to communicate
                    // with the remote node anymore
                    vFlags = RST | ACK;
                    bCloseSocket = TRUE;
                }
                break;

                //			case TCP_TIME_WAIT:
                //				// Wait around for a while (2MSL) and then goto closed state
                //				bCloseSocket = TRUE;
                //				break;
                //

            case TCP_LAST_ACK:
                // Send some more FINs or close anyway
                if (MyTCB.retryCount < TCP_MAX_RETRIES) {
                    vFlags = FIN | ACK;
                    bRetransmit = TRUE;
                } else {
                    vFlags = RST | ACK;
                    bCloseSocket = TRUE;
                }
                break;

            default:
                break;
        }

        if (vFlags) {
            // Transmit all unacknowledged data over again
            if (bRetransmit) {
                // Set the appropriate retry time
                MyTCB.retryCount++;
                MyTCB.retryInterval <<= 1;

                // Calculate how many bytes we have to roll back and retransmit
                w = MyTCB.txUnackedTail - MyTCBStub.txTail;
                if (MyTCB.txUnackedTail < MyTCBStub.txTail)
                    w += MyTCBStub.bufferRxStart - MyTCBStub.bufferTxStart;

                // Perform roll back of local SEQuence counter, remote window
                // adjustment, and cause all unacknowledged data to be
                // retransmitted by moving the unacked tail pointer.
                MyTCB.MySEQ -= w;
                MyTCB.remoteWindow += w;
                MyTCB.txUnackedTail = MyTCBStub.txTail;
                SendTCP(vFlags, 0);
            } else
                SendTCP(vFlags, SENDTCP_RESET_TIMERS);

        }

        if (bCloseSocket)
            CloseSocket();
    }


#if TCP_SYN_QUEUE_MAX_ENTRIES
    // Process SYN Queue entry timeouts
    for (w = 0; w < TCP_SYN_QUEUE_MAX_ENTRIES; w++) {
        // Abort search if there are no more valid records
        if (SYNQueue[w].wDestPort == 0u)
            break;

        // See if this SYN has timed out
        if ((WORD) TickGetDiv256() - SYNQueue[w].wTimestamp > (WORD) (TCP_SYN_QUEUE_TIMEOUT / 256ull)) {
            // Delete this SYN from the SYNQueue and compact the SYNQueue[] array
            TCPRAMCopy((PTR_BASE) & SYNQueue[w], TCP_PIC_RAM, (PTR_BASE) & SYNQueue[w + 1], TCP_PIC_RAM, (TCP_SYN_QUEUE_MAX_ENTRIES - 1u - w) * sizeof (TCP_SYN_QUEUE));
            SYNQueue[TCP_SYN_QUEUE_MAX_ENTRIES - 1].wDestPort = 0u;

            // Since we deleted an entry, we need to roll back one
            // index so next loop will process the correct record
            w--;
        }
    }
#endif
}

/*****************************************************************************
  Function:
        BOOL TCPProcess(NODE_INFO* remote, IP_ADDR* localIP, WORD len)

  Summary:
        Handles incoming TCP segments.

  Description:
        This function handles incoming TCP segments.  When a segment arrives, it
        is compared to open sockets using a hash of the remote port and IP.
        On a match, the data is passed to HandleTCPSeg for further processing.

  Precondition:
        TCP is initialized and a TCP segment is ready in the MAC buffer.

  Parameters:
        remote - Remote NODE_INFO structure
        localIP - This stack's IP address (for header checking)
        len - Total length of the waiting TCP segment

  Return Values:
        TRUE - the segment was properly handled.
        FALSE - otherwise
 ***************************************************************************/
extern int location;
BOOL TCPProcess(NODE_INFO* remote, IP_ADDR* localIP, WORD len) {
    TCP_HEADER TCPHeader;
    PSEUDO_HEADER pseudoHeader;
    WORD_VAL checksum1;
    WORD_VAL checksum2;
    BYTE optionsSize;

    // Calculate IP pseudoheader checksum.
    pseudoHeader.SourceAddress = remote->IPAddr;
    pseudoHeader.DestAddress = *localIP;
    pseudoHeader.Zero = 0x0;
    pseudoHeader.Protocol = IP_PROT_TCP;
    pseudoHeader.Length = len;

    SwapPseudoHeader(pseudoHeader);

    checksum1.Val = ~CalcIPChecksum((BYTE*) & pseudoHeader,
            sizeof (pseudoHeader));

    // Now calculate TCP packet checksum in NIC RAM - should match
    // pesudo header checksum
    checksum2.Val = CalcIPBufferChecksum(len);

    // Compare checksums.
    if (checksum1.Val != checksum2.Val) {
        location = 0x200;
        MACDiscardRx();
        return TRUE;
    }

#if defined(DEBUG_GENERATE_RX_LOSS)
    // Throw RX packets away randomly
    if (LFSRRand() > DEBUG_GENERATE_RX_LOSS) {
        MACDiscardRx();
        return TRUE;
    }
#endif

    // Retrieve TCP header.
    IPSetRxBuffer(0);
    MACGetArray((BYTE*) & TCPHeader, sizeof (TCPHeader));
    SwapTCPHeader(&TCPHeader);


    // Skip over options to retrieve data bytes
    optionsSize = (BYTE) ((TCPHeader.DataOffset.Val << 2) -
            sizeof (TCPHeader));
    len = len - optionsSize - sizeof (TCPHeader);

    location = 0x201;
    // Find matching socket.
    if (FindMatchingSocket(&TCPHeader, remote)) {
#if defined(STACK_USE_SSL)
        PTR_BASE prevRxHead;
        // For SSL connections, show HandleTCPSeg() the full data buffer
        prevRxHead = MyTCBStub.rxHead;
        if (MyTCBStub.sslStubID != SSL_INVALID_ID)
            MyTCBStub.rxHead = MyTCBStub.sslRxHead;
#endif
        location = 0x202;
        HandleTCPSeg(&TCPHeader, len);

#if defined(STACK_USE_SSL)
        if (MyTCBStub.sslStubID != SSL_INVALID_ID) {
            // Restore the buffer state
            MyTCBStub.sslRxHead = MyTCBStub.rxHead;
            MyTCBStub.rxHead = prevRxHead;

            // Process the new SSL data, using the currently loaded stub
            TCPSSLHandleIncoming(hCurrentTCP);
        }
#endif
    }
    //	else
    //	{
    //		// NOTE: RFC 793 specifies that if the socket is closed and a segment
    //		// arrives, we should send back a RST if the RST bit in the incoming
    //		// packet is not set.  Instead, we will just silently ignore such a
    //		// packet since this is what firewalls do on purpose to enhance
    //		// security.
    //		//if(!TCPHeader.Flags.bits.flagRST)
    //		//	SendTCP(RST, SENDTCP_RESET_TIMERS);
    //	}

    // Finished with this packet, discard it and free the Ethernet RAM for new packets
    location = 0x203;
    MACDiscardRx();

    return TRUE;
}

/*****************************************************************************
  Function:
        static void SendTCP(BYTE vTCPFlags, BYTE vSendFlags)

  Summary:
        Transmits a TPC segment.

  Description:
        This function assembles and transmits a TCP segment, including any
        pending data.  It also supports retransmissions, keep-alives, and
        other packet types.

  Precondition:
        TCP is initialized.

  Parameters:
        vTCPFlags - Additional TCP flags to include
        vSendFlags - Any combinations of SENDTCP_* constants to modify the
                                 transmit behavior or contents.

  Returns:
        None
 ***************************************************************************/
static void SendTCP(BYTE vTCPFlags, BYTE vSendFlags) {
    WORD_VAL wVal;
    TCP_HEADER header;
    TCP_OPTIONS options;
    PSEUDO_HEADER pseudoHeader;
    WORD len;

    SyncTCB();

    // FINs must be handled specially
    if (vTCPFlags & FIN) {
        MyTCBStub.Flags.bTXFIN = 1;
        vTCPFlags &= ~FIN;
    }

    // Status will now be synched, disable automatic future
    // status transmissions
    MyTCBStub.Flags.bTimer2Enabled = 0;
    MyTCBStub.Flags.bDelayedACKTimerEnabled = 0;
    MyTCBStub.Flags.bOneSegmentReceived = 0;
    MyTCBStub.Flags.bTXASAP = 0;
    MyTCBStub.Flags.bTXASAPWithoutTimerReset = 0;
    MyTCBStub.Flags.bHalfFullFlush = 0;

    //  Make sure that we can write to the MAC transmit area
    int i = 0;
    while (!IPIsTxReady()){
        if(i++ > 1000){
            MACFlush();
            return;
        }
    };

    // Put all socket application data in the TX space
    if (vTCPFlags & (SYN | RST)) {
        // Don't put any data in SYN and RST messages
        len = 0;
    } else {
        // Begin copying any application data over to the TX space
        if (MyTCBStub.txHead == MyTCB.txUnackedTail) {
            // All caught up on data TX, no real data for this packet
            len = 0;
        } else if (MyTCBStub.txHead > MyTCB.txUnackedTail) {
            len = MyTCBStub.txHead - MyTCB.txUnackedTail;

            if (len > MyTCB.remoteWindow)
                len = MyTCB.remoteWindow;

            if (len > MyTCB.wRemoteMSS) {
                len = MyTCB.wRemoteMSS;
                MyTCBStub.Flags.bTXASAPWithoutTimerReset = 1;
            }

            // Copy application data into the raw TX buffer
            TCPRAMCopy(BASE_TX_ADDR + sizeof (ETHER_HEADER) + sizeof (IP_HEADER) + sizeof (TCP_HEADER), TCP_ETH_RAM, MyTCB.txUnackedTail, MyTCBStub.vMemoryMedium, len);
            MyTCB.txUnackedTail += len;
        } else {
            pseudoHeader.Length = MyTCBStub.bufferRxStart - MyTCB.txUnackedTail;
            len = pseudoHeader.Length + MyTCBStub.txHead - MyTCBStub.bufferTxStart;

            if (len > MyTCB.remoteWindow)
                len = MyTCB.remoteWindow;

            if (len > MyTCB.wRemoteMSS) {
                len = MyTCB.wRemoteMSS;
                MyTCBStub.Flags.bTXASAPWithoutTimerReset = 1;
            }

            if (pseudoHeader.Length > len)
                pseudoHeader.Length = len;

            // Copy application data into the raw TX buffer
            TCPRAMCopy(BASE_TX_ADDR + sizeof (ETHER_HEADER) + sizeof (IP_HEADER) + sizeof (TCP_HEADER), TCP_ETH_RAM, MyTCB.txUnackedTail, MyTCBStub.vMemoryMedium, pseudoHeader.Length);
            pseudoHeader.Length = len - pseudoHeader.Length;

            // Copy any left over chunks of application data over
            if (pseudoHeader.Length) {
                TCPRAMCopy(BASE_TX_ADDR + sizeof (ETHER_HEADER) + sizeof (IP_HEADER) + sizeof (TCP_HEADER)+(MyTCBStub.bufferRxStart - MyTCB.txUnackedTail), TCP_ETH_RAM, MyTCBStub.bufferTxStart, MyTCBStub.vMemoryMedium, pseudoHeader.Length);
            }

            MyTCB.txUnackedTail += len;
            if (MyTCB.txUnackedTail >= MyTCBStub.bufferRxStart)
                MyTCB.txUnackedTail -= MyTCBStub.bufferRxStart - MyTCBStub.bufferTxStart;
        }

        // If we are to transmit a FIN, make sure we can put one in this packet
        if (MyTCBStub.Flags.bTXFIN) {
            if ((len != MyTCB.remoteWindow) && (len != MyTCB.wRemoteMSS))
                vTCPFlags |= FIN;
        }
    }

    // Ensure that all packets with data of some kind are
    // retransmitted by TCPTick() until acknowledged
    // Pure ACK packets with no data are not ACKed back in TCP
    if (len || (vTCPFlags & (SYN | FIN))) {
        // Transmitting data, update remote window variable to reflect smaller
        // window.
        MyTCB.remoteWindow -= len;

        // Push (PSH) all data for enhanced responsiveness on
        // the remote end, especially with GUIs
        if (len)
            vTCPFlags |= PSH;

        if (vSendFlags & SENDTCP_RESET_TIMERS) {
            MyTCB.retryCount = 0;
            MyTCB.retryInterval = TCP_START_TIMEOUT_VAL;
        }

        MyTCBStub.eventTime = TickGet() + MyTCB.retryInterval;
        MyTCBStub.Flags.bTimerEnabled = 1;
    } else if (vSendFlags & SENDTCP_KEEP_ALIVE) {
        // Increment Keep Alive TX counter to handle disconnection if not response is returned
        MyTCBStub.Flags.vUnackedKeepalives++;

        // Generate a dummy byte
        MyTCB.MySEQ -= 1;
        len = 1;
    } else if (MyTCBStub.Flags.bTimerEnabled) {
        // If we have data to transmit, but the remote RX window is zero,
        // so we aren't transmitting any right now then make sure to not
        // extend the retry counter or timer.  This will stall our TX
        // with a periodic ACK sent to the remote node.
        if (!(vSendFlags & SENDTCP_RESET_TIMERS)) {
            // Roll back retry counters since we can't send anything,
            // but only if we incremented it in the first place
            if (MyTCB.retryCount) {
                MyTCB.retryCount--;
                MyTCB.retryInterval >>= 1;
            }
        }

        MyTCBStub.eventTime = TickGet() + MyTCB.retryInterval;
    }


    header.SourcePort = MyTCB.localPort.Val;
    header.DestPort = MyTCB.remotePort.Val;
    header.SeqNumber = MyTCB.MySEQ;
    header.AckNumber = MyTCB.RemoteSEQ;
    header.Flags.bits.Reserved2 = 0;
    header.DataOffset.Reserved3 = 0;
    header.Flags.byte = vTCPFlags;
    header.UrgentPointer = 0;

    // Update our send sequence number and ensure retransmissions
    // of SYNs and FINs use the right sequence number
    MyTCB.MySEQ += (DWORD) len;
    if (vTCPFlags & SYN) {
        // SEG.ACK needs to be zero for the first SYN packet for compatibility
        // with certain paranoid TCP/IP stacks, even though the ACK flag isn't
        // set (indicating that the AckNumber field is unused).
        if (!(vTCPFlags & ACK))
            header.AckNumber = 0x00000000;

        if (MyTCB.flags.bSYNSent)
            header.SeqNumber--;
        else {
            MyTCB.MySEQ++;
            MyTCB.flags.bSYNSent = 1;
        }
    }
    if (vTCPFlags & FIN) {
        if (MyTCB.flags.bFINSent)
            header.SeqNumber--;
        else {
            MyTCB.MySEQ++;
            MyTCB.flags.bFINSent = 1;
        }
    }

    // Calculate the amount of free space in the RX buffer area of this socket
    if (MyTCBStub.rxHead >= MyTCBStub.rxTail)
        header.Window = (MyTCBStub.bufferEnd - MyTCBStub.bufferRxStart) - (MyTCBStub.rxHead - MyTCBStub.rxTail);
    else
        header.Window = MyTCBStub.rxTail - MyTCBStub.rxHead - 1;

    // Calculate the amount of free space in the MAC RX buffer area and adjust window if needed
    wVal.Val = MACGetFreeRxSize();
    if (wVal.Val < 64) {
        wVal.Val = 0;
    } else {
        wVal.Val -= 64;
    }
    // Force the remote node to throttle back if we are running low on general RX buffer space
    if (header.Window > wVal.Val)
        header.Window = wVal.Val;

    SwapTCPHeader(&header);


    len += sizeof (header);
    header.DataOffset.Val = sizeof (header) >> 2;

    // Insert the MSS (Maximum Segment Size) TCP option if this is SYN packet
    if (vTCPFlags & SYN) {
        len += sizeof (options);
        options.Kind = TCP_OPTIONS_MAX_SEG_SIZE;
        options.Length = 0x04;

        // Load MSS and swap to big endian
        options.MaxSegSize.Val = (((TCP_MAX_SEG_SIZE_RX)&0x00FF) << 8) | (((TCP_MAX_SEG_SIZE_RX)&0xFF00) >> 8);

        header.DataOffset.Val += sizeof (options) >> 2;
    }

    // Calculate IP pseudoheader checksum.
    pseudoHeader.SourceAddress = AppConfig.MyIPAddr;
    pseudoHeader.DestAddress = MyTCB.remote.niRemoteMACIP.IPAddr;
    pseudoHeader.Zero = 0x0;
    pseudoHeader.Protocol = IP_PROT_TCP;
    pseudoHeader.Length = len;
    SwapPseudoHeader(pseudoHeader);
    header.Checksum = ~CalcIPChecksum((BYTE*) & pseudoHeader, sizeof (pseudoHeader));

    // Write IP header
    MACSetWritePtr(BASE_TX_ADDR + sizeof (ETHER_HEADER));
    IPPutHeader(&MyTCB.remote.niRemoteMACIP, IP_PROT_TCP, len);
    MACPutArray((BYTE*) & header, sizeof (header));
    if (vTCPFlags & SYN)
        MACPutArray((BYTE*) & options, sizeof (options));

    // Update the TCP checksum
    MACSetReadPtr(BASE_TX_ADDR + sizeof (ETHER_HEADER) + sizeof (IP_HEADER));
    wVal.Val = CalcIPBufferChecksum(len);
#if defined(DEBUG_GENERATE_TX_LOSS)
    // Damage TCP checksums on TX packets randomly
    if (LFSRRand() > DEBUG_GENERATE_TX_LOSS) {
        wVal.Val++;
    }
#endif
    MACSetWritePtr(BASE_TX_ADDR + sizeof (ETHER_HEADER) + sizeof (IP_HEADER) + 16);
    MACPutArray((BYTE*) & wVal, sizeof (WORD));

    // Physically start the packet transmission over the network
    MACFlush();
}

/*****************************************************************************
  Function:
        static BOOL FindMatchingSocket(TCP_HEADER* h, NODE_INFO* remote)

  Summary:
        Finds a suitable socket for a TCP segment.

  Description:
        This function searches through the sockets and attempts to match one with
        a given TCP header and NODE_INFO structure.  If a socket is found, its
        index is saved in hCurrentTCP and the associated MyTCBStub and MyTCB are
        loaded. Otherwise, INVALID_SOCKET is placed in hCurrentTCP.
	
  Precondition:
        TCP is initialized.

  Parameters:
        h - TCP header to be matched against
        remote - The remote node who sent this header

  Return Values:
        TRUE - A match was found and is loaded in hCurrentTCP
        FALSE - No suitable socket was found and hCurrentTCP is INVALID_SOCKET
 ***************************************************************************/
static BOOL FindMatchingSocket(TCP_HEADER* h, NODE_INFO* remote) {
    TCP_SOCKET hTCP;
    TCP_SOCKET partialMatch;
    WORD hash;

    // Prevent connections on invalid port 0
    if (h->DestPort == 0u)
        return FALSE;

    partialMatch = INVALID_SOCKET;
    hash = (remote->IPAddr.w[1] + remote->IPAddr.w[0] + h->SourcePort) ^ h->DestPort;

    // Loop through all sockets looking for a socket that is expecting this
    // packet or can handle it.
    for (hTCP = 0; hTCP < TCP_SOCKET_COUNT; hTCP++) {
        SyncTCBStub(hTCP);

        if (MyTCBStub.smState == TCP_CLOSED) {
            continue;
        } else if (MyTCBStub.smState == TCP_LISTEN) {// For listening ports, check if this is the correct port
            if (MyTCBStub.remoteHash.Val == h->DestPort)
                partialMatch = hTCP;

#if defined(STACK_USE_SSL_SERVER)
            // Check the SSL port as well for SSL Servers
            // 0 is defined as an invalid port number
            if (MyTCBStub.sslTxHead == h->DestPort)
                partialMatch = hTCP;
#endif

            continue;
        } else if (MyTCBStub.remoteHash.Val != hash) {// Ignore if the hash doesn't match
            continue;
        }

        SyncTCB();
        if (h->DestPort == MyTCB.localPort.Val &&
                h->SourcePort == MyTCB.remotePort.Val &&
                remote->IPAddr.Val == MyTCB.remote.niRemoteMACIP.IPAddr.Val) {
            return TRUE;
        }
    }


    // If there is a partial match, then a listening socket is currently
    // available.  Set up the extended TCB with the info needed
    // to establish a connection and return this socket to the
    // caller.
    if (partialMatch != INVALID_SOCKET) {
        SyncTCBStub(partialMatch);
        SyncTCB();

        // For SSL ports, begin the SSL Handshake
#if defined(STACK_USE_SSL_SERVER)
        if (MyTCBStub.sslTxHead == h->DestPort) {
            // Try to start an SSL session.  If no stubs are available,
            // we can't service this request right now, so ignore it.
            if (!TCPStartSSLServer(partialMatch))
                partialMatch = INVALID_SOCKET;
        }
#endif

        // Make sure the above check didn't fail (this is unfortunately
        // redundant for non-SSL sockets).  Otherwise, fall out to below
        // and add to the SYN queue.
        if (partialMatch != INVALID_SOCKET) {
            MyTCBStub.remoteHash.Val = hash;

            memcpy((void*) &MyTCB.remote, (void*) remote, sizeof (NODE_INFO));
            MyTCB.remotePort.Val = h->SourcePort;
            MyTCB.localPort.Val = h->DestPort;
            MyTCB.txUnackedTail = MyTCBStub.bufferTxStart;

            // All done, and we have a match
            return TRUE;
        }
    }

    // No available sockets are listening on this port.  (Or, for
    // SSL requests, perhaps no SSL sessions were available.  However,
    // there may be a server socket which is currently busy but
    // could handle this packet, so we should check.
#if TCP_SYN_QUEUE_MAX_ENTRIES
    {
        WORD wQueueInsertPos;

        // See if this is a SYN packet
        if (!h->Flags.bits.flagSYN)
            return FALSE;

        // See if there is space in our SYN queue
        if (SYNQueue[TCP_SYN_QUEUE_MAX_ENTRIES - 1].wDestPort)
            return FALSE;

        // See if we have this SYN already in our SYN queue.
        // If not already in the queue, find out where we
        // should insert this SYN to the queue
        for (wQueueInsertPos = 0; wQueueInsertPos < TCP_SYN_QUEUE_MAX_ENTRIES; wQueueInsertPos++) {
            // Exit loop if we found a free record
            if (SYNQueue[wQueueInsertPos].wDestPort == 0u)
                break;

            // Check if this SYN packet is already in the SYN queue
            if (SYNQueue[wQueueInsertPos].wDestPort != h->DestPort)
                continue;
            if (SYNQueue[wQueueInsertPos].wSourcePort != h->SourcePort)
                continue;
            if (SYNQueue[wQueueInsertPos].niSourceAddress.IPAddr.Val != remote->IPAddr.Val)
                continue;

            // SYN matches SYN queue entry.  Update timestamp and do nothing.
            SYNQueue[wQueueInsertPos].wTimestamp = TickGetDiv256();
            return FALSE;
        }

        // Check to see if we have any server sockets which
        // are currently connected, but could handle this SYN
        // request at a later time if the client disconnects.
        for (hTCP = 0; hTCP < TCP_SOCKET_COUNT; hTCP++) {
            SyncTCBStub(hTCP);
            if (!MyTCBStub.Flags.bServer)
                continue;

            SyncTCB();
#if defined(STACK_USE_SSL_SERVER)
            if ((MyTCB.localPort.Val != h->DestPort) && (MyTCB.localSSLPort.Val != h->DestPort))
#else
            if (MyTCB.localPort.Val != h->DestPort)
#endif
                continue;

            // Generate the SYN queue entry
            memcpy((void*) &SYNQueue[wQueueInsertPos].niSourceAddress, (void*) remote, sizeof (NODE_INFO));
            SYNQueue[wQueueInsertPos].wSourcePort = h->SourcePort;
            SYNQueue[wQueueInsertPos].dwSourceSEQ = h->SeqNumber;
            SYNQueue[wQueueInsertPos].wDestPort = h->DestPort;
            SYNQueue[wQueueInsertPos].wTimestamp = TickGetDiv256();

            return FALSE;
        }
    }
#endif

    return FALSE;

}

/*****************************************************************************
  Function:
        static void SwapTCPHeader(TCP_HEADER* header)

  Summary:
        Swaps endian-ness of a TCP header.

  Description:
        This function swaps the endian-ness of a given TCP header for comparison.

  Precondition:
        None

  Parameters:
        header - The TCP header that is to be swapped

  Returns:
        None
 ***************************************************************************/
static void SwapTCPHeader(TCP_HEADER* header) {
    header->SourcePort = swaps(header->SourcePort);
    header->DestPort = swaps(header->DestPort);
    header->SeqNumber = swapl(header->SeqNumber);
    header->AckNumber = swapl(header->AckNumber);
    header->Window = swaps(header->Window);
    header->Checksum = swaps(header->Checksum);
    header->UrgentPointer = swaps(header->UrgentPointer);
}
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
