whiteway11890/PIC32_Dev/Firmware/Ethernet/src/ethernet_entry.c

/*********************************************************************
 *
 *  Main Application Entry Point and TCP/IP Stack Demo
 *  Module for Microchip TCP/IP Stack
 *   -Demonstrates how to call and use the Microchip TCP/IP stack
 *	 -Reference: Microchip TCP/IP Stack Help (TCPIP Stack Help.chm)
 *
 *********************************************************************
 * FileName:        MainDemo.c
 * Dependencies:    TCPIP.h
 * Processor:       PIC18, PIC24F, PIC24H, dsPIC30F, dsPIC33F, PIC32
 * Compiler:        Microchip C32 v1.11b or higher
 *					Microchip C30 v3.24 or higher
 *					Microchip C18 v3.36 or higher
 * Company:         Microchip Technology, Inc.
 *
 * Software License Agreement
 *
 * Copyright (C) 2002-2010 Microchip Technology Inc.  All rights
 * reserved.
 *
 * Microchip licenses to you the right to use, modify, copy, and
 * distribute:
 * (i)  the Software when embedded on a Microchip microcontroller or
 *      digital signal controller product ("Device") which is
 *      integrated into Licensee's product; or
 * (ii) ONLY the Software driver source files ENC28J60.c, ENC28J60.h,
 *		ENCX24J600.c and ENCX24J600.h ported to a non-Microchip device
 *		used in conjunction with a Microchip ethernet controller for
 *		the sole purpose of interfacing with the ethernet controller.
 *
 * You should refer to the license agreement accompanying this
 * Software for additional information regarding your rights and
 * obligations.
 *
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
 * File Description:
 * Change History:
 * Rev   Description
 * ----  -----------------------------------------
 * 1.0   Initial release
 * V5.36 ---- STACK_USE_MPFS support has been removed
 ********************************************************************/
/*
 * This macro uniquely defines this file as the main entry point.
 * There should only be one such definition in the entire project,
 * and this file must define the AppConfig variable as described below.
 */

#define THIS_IS_STACK_APPLICATION

// Include all headers for any enabled TCPIP Stack functions
#include "LCD.h"
#include "HardwareProfile.h"
#include "Tick.h"
#include "StackTsk.h"
#include "GenericTypeDefs.h"
#include "Compiler.h"
#include "TCPIPConfig.h"
#include "TCP.h"

#if defined(STACK_USE_ZEROCONF_LINK_LOCAL)
#include "TCPIP Stack/ZeroconfLinkLocal.h"
#endif
#if defined(STACK_USE_ZEROCONF_MDNS_SD)
#include "TCPIP Stack/ZeroconfMulticastDNS.h"
#endif

// Include functions specific to this stack application
#include "ethernet_entry.h"

// Used for Wi-Fi assertions
#define WF_MODULE_NUMBER   WF_MODULE_MAIN_DEMO

// Declare AppConfig structure and some other supporting stack variables
APP_CONFIG AppConfig;
static unsigned short wOriginalAppConfigChecksum; // Checksum of the ROM defaults for AppConfig
BYTE AN0String[8];
int location;

// Use UART2 instead of UART1 for stdout (printf functions).  Explorer 16
// serial port hardware is on PIC UART2 module.
#if defined(EXPLORER_16) || defined(PIC24FJ256DA210_DEV_BOARD)
int __C30_UART = 2;
#endif


// Private helper functions.
// These may or may not be present in all applications.
static void InitAppConfig(void);
static void InitializeBoard(void);
static void ProcessIO(void);
#if defined(WF_CS_TRIS)
static void WF_Connect(void);
extern BOOL gRFModuleVer1209orLater;
#endif

//
// PIC18 Interrupt Service Routines
//
// NOTE: Several PICs, including the PIC18F4620 revision A3 have a RETFIE FAST/MOVFF bug
// The interruptlow keyword is used to work around the bug when using C18
#if defined(__C32__)

void _general_exception_handler(unsigned cause, unsigned status) {
    int tmp = 1;
}
#endif


//
// Main application entry point.
//
int ethernetMain(void)
{
    static DWORD t = 0;
    static DWORD dwLastIP = 0;

    // Initialize application specific hardware
    InitializeBoard();

#if defined(USE_LCD)
    // Initialize and display the stack version on the LCD
    LCDInit();
    DelayMs(100);
    strcpypgm2ram((char*) LCDText, "TCPStack " TCPIP_STACK_VERSION "  "
            "                ");
    LCDUpdate();
#endif

    // Initialize stack-related hardware components that may be
    // required by the UART configuration routines
    LED_PUT(0x03);
    TickInit();
#if defined(STACK_USE_MPFS2)
    MPFSInit();
#endif

    // Initialize Stack and application related NV variables into AppConfig.
    InitAppConfig();

    // Initiates board setup process if button is depressed
    // on startup
    if (BUTTON0_IO == 0u) {
#if defined(EEPROM_CS_TRIS) || defined(SPIFLASH_CS_TRIS)
        // Invalidate the EEPROM contents if BUTTON0 is held down for more than 4 seconds
        DWORD StartTime = TickGet();
        LED_PUT(0x00);

        while (BUTTON0_IO == 0u) {
            if (TickGet() - StartTime > 4 * TICK_SECOND) {
#if defined(EEPROM_CS_TRIS)
                XEEBeginWrite(0x0000);
                XEEWrite(0xFF);
                XEEWrite(0xFF);
                XEEEndWrite();
#elif defined(SPIFLASH_CS_TRIS)
                SPIFlashBeginWrite(0x0000);
                SPIFlashWrite(0xFF);
                SPIFlashWrite(0xFF);
#endif

#if defined(STACK_USE_UART)
                putrsUART("\r\n\r\nBUTTON0 held for more than 4 seconds.  Default settings restored.\r\n\r\n");
#endif

                LED_PUT(0x0F);
                while ((LONG) (TickGet() - StartTime) <= (LONG) (9 * TICK_SECOND / 2));
                LED_PUT(0x00);
                while (BUTTON0_IO == 0u);
                Reset();
                break;
            }
        }

        LED_PUT(0xFF);
#endif

#if defined(STACK_USE_UART)
        DoUARTConfig();
#endif
    }

    // Initialize core stack layers (MAC, ARP, TCP, UDP) and
    // application modules (HTTP, SNMP, etc.)
    StackInit();

#if defined(WF_CS_TRIS)
    WF_Connect();
#endif

    // Initialize any application-specific modules or functions/
    // For this demo application, this only includes the
    // UART 2 TCP Bridge
#if defined(STACK_USE_UART2TCP_BRIDGE)
    UART2TCPBridgeInit();
#endif

#if defined(STACK_USE_ZEROCONF_LINK_LOCAL)
    ZeroconfLLInitialize();
#endif

#if defined(STACK_USE_ZEROCONF_MDNS_SD)
    mDNSInitialize(MY_DEFAULT_HOST_NAME);
    mDNSServiceRegister(
            (const char *) "DemoWebServer", // base name of the service
            "_http._tcp.local", // type of the service
            80, // TCP or UDP port, at which this service is available
            ((const BYTE *) "path=/index.htm"), // TXT info
            1, // auto rename the service when if needed
            NULL, // no callback function
            NULL // no application context
            );

    mDNSMulticastFilterRegister();
#endif

    LCDPrintEthernet();

    // Now that all items are initialized, begin the co-operative
    // multitasking loop.  This infinite loop will continuously
    // execute all stack-related tasks, as well as your own
    // application's functions.  Custom functions should be added
    // at the end of this loop.
    // Note that this is a "co-operative mult-tasking" mechanism
    // where every task performs its tasks (whether all in one shot
    // or part of it) and returns so that other tasks can do their
    // job.
    // If a task needs very long time to do its job, it must be broken
    // down into smaller pieces so that other tasks can have CPU time.
    while (1) {
        location = 0;
        // Blink LED0 (right most one) every second.
        if (TickGet() - t >= TICK_SECOND / 2ul) {
            t = TickGet();
            LED0_IO ^= 1;
        }

        // This task performs normal stack task including checking
        // for incoming packet, type of packet and calling
        // appropriate stack entity to process it.
        location = 11;
        StackTask();

#if defined(WF_CS_TRIS)
        if (gRFModuleVer1209orLater)
            WiFiTask();
#endif

        // This tasks invokes each of the core stack application tasks
        location = 12;
        StackApplications();

#if defined(STACK_USE_ZEROCONF_LINK_LOCAL)
        ZeroconfLLProcess();
#endif

#if defined(STACK_USE_ZEROCONF_MDNS_SD)
        mDNSProcess();
        // Use this function to exercise service update function
        // HTTPUpdateRecord();
#endif

        // Process application specific tasks here.
        // For this demo app, this will include the Generic TCP
        // client and servers, and the SNMP, Ping, and SNMP Trap
        // demos.  Following that, we will process any IO from
        // the inputs on the board itself.
        // Any custom modules or processing you need to do should
        // go here.
#if defined(STACK_USE_GENERIC_TCP_CLIENT_EXAMPLE)
        GenericTCPClient();
#endif

#if defined(STACK_USE_GENERIC_TCP_SERVER_EXAMPLE)
        GenericTCPServer();
#endif

#if defined(STACK_USE_SMTP_CLIENT)
        SMTPDemo();
#endif

#if defined(STACK_USE_ICMP_CLIENT)
        PingDemo();
#endif

#if defined(STACK_USE_SNMP_SERVER) && !defined(SNMP_TRAP_DISABLED)
        //User should use one of the following SNMP demo
        // This routine demonstrates V1 or V2 trap formats with one variable binding.
        SNMPTrapDemo();

#if defined(SNMP_STACK_USE_V2_TRAP) || defined(SNMP_V1_V2_TRAP_WITH_SNMPV3)
        //This routine provides V2 format notifications with multiple (3) variable bindings
        //User should modify this routine to send v2 trap format notifications with the required varbinds.
        //SNMPV2TrapDemo();
#endif
        if (gSendTrapFlag)
            SNMPSendTrap();
#endif

#if defined(STACK_USE_BERKELEY_API)
        BerkeleyTCPClientDemo();
        BerkeleyTCPServerDemo();
        BerkeleyUDPClientDemo();
#endif
        location = 3;
        ProcessIO();

        // If the local IP address has changed (ex: due to DHCP lease change)
        // write the new IP address to the LCD display, UART, and Announce
        // service
        location = 4;
        if (dwLastIP != AppConfig.MyIPAddr.Val) {
            dwLastIP = AppConfig.MyIPAddr.Val;

#if defined(STACK_USE_UART)
            putrsUART((ROM char*) "\r\nNew IP Address: ");
#endif
            location = 5;
            DisplayIPValue(AppConfig.MyIPAddr);
            getLCDData()->address = AppConfig.MyIPAddr;
            LCDPrintEthernet();

#if defined(STACK_USE_UART)
            putrsUART((ROM char*) "\r\n");
#endif


#if defined(STACK_USE_ANNOUNCE)
            AnnounceIP();
#endif

#if defined(STACK_USE_ZEROCONF_MDNS_SD)
            mDNSFillHostRecord();
#endif
        }
    }
}

#if defined(WF_CS_TRIS)

/*****************************************************************************
 * FUNCTION: WF_Connect
 *
 * RETURNS:  None
 *
 * PARAMS:   None
 *
 *  NOTES:   Connects to an 802.11 network.  Customize this function as needed
 *           for your application.
 *****************************************************************************/
static void WF_Connect(void) {
    UINT8 ConnectionProfileID;
    UINT8 channelList[] = MY_DEFAULT_CHANNEL_LIST;

    /* create a Connection Profile */
    WF_CPCreate(&ConnectionProfileID);

#if defined(STACK_USE_UART)
    putrsUART("Set SSID (");
    putsUART(AppConfig.MySSID);
    putrsUART(")\r\n");
#endif
    WF_CPSetSsid(ConnectionProfileID,
            AppConfig.MySSID,
            AppConfig.SsidLength);

#if defined(STACK_USE_UART)
    putrsUART("Set Network Type\r\n");
#endif
    WF_CPSetNetworkType(ConnectionProfileID, MY_DEFAULT_NETWORK_TYPE);

#if defined(STACK_USE_UART)
    putrsUART("Set Scan Type\r\n");
#endif
    WF_CASetScanType(MY_DEFAULT_SCAN_TYPE);

#if defined(STACK_USE_UART)
    putrsUART("Set Channel List\r\n");
#endif
    WF_CASetChannelList(channelList, sizeof (channelList));

#if defined(STACK_USE_UART)
    putrsUART("Set list retry count\r\n");
#endif
    // The Retry Count parameter tells the WiFi Connection manager how many attempts to make when trying
    // to connect to an existing network.  In the Infrastructure case, the default is to retry forever so that
    // if the AP is turned off or out of range, the radio will continue to attempt a connection until the
    // AP is eventually back on or in range.  In the Adhoc case, the default is to retry 3 times since the
    // purpose of attempting to establish a network in the Adhoc case is only to verify that one does not
    // initially exist.  If the retry count was set to WF_RETRY_FOREVER in the AdHoc mode, an AdHoc network
    // would never be established.  The constants MY_DEFAULT_LIST_RETRY_COUNT_ADHOC and
    // MY_DEFAULT_LIST_RETRY_COUNT_INFRASTRUCTURE have been created specifically for the June 2011 MAL release.
#if defined(EZ_CONFIG_STORE)
    if (AppConfig.networkType == WF_ADHOC)
        WF_CASetListRetryCount(MY_DEFAULT_LIST_RETRY_COUNT_ADHOC);
    else
        WF_CASetListRetryCount(MY_DEFAULT_LIST_RETRY_COUNT_INFRASTRUCTURE);
#else
#if (MY_DEFAULT_NETWORK_TYPE == WF_ADHOC)
    WF_CASetListRetryCount(MY_DEFAULT_LIST_RETRY_COUNT_ADHOC);
#else
    WF_CASetListRetryCount(MY_DEFAULT_LIST_RETRY_COUNT_INFRASTRUCTURE);
#endif
#endif


#if defined(STACK_USE_UART)
    putrsUART("Set Event Notify\r\n");
#endif
    WF_CASetEventNotificationAction(MY_DEFAULT_EVENT_NOTIFICATION_LIST);

#if defined(STACK_USE_UART)
    putrsUART("Set Beacon Timeout\r\n");
#endif
    WF_CASetBeaconTimeout(40);

    if (gRFModuleVer1209orLater) {
        // If WEP security is used, set WEP Key Type.  The default WEP Key Type is Shared Key.
        if (AppConfig.SecurityMode == WF_SECURITY_WEP_40 || AppConfig.SecurityMode == WF_SECURITY_WEP_104) {
            WF_CPSetWepKeyType(ConnectionProfileID, MY_DEFAULT_WIFI_SECURITY_WEP_KEYTYPE);
        }
    }

    /* Set Security */
#if (MY_DEFAULT_WIFI_SECURITY_MODE == WF_SECURITY_OPEN)
#if defined(STACK_USE_UART)
    putrsUART("Set Security (Open)\r\n");
#endif
#elif (MY_DEFAULT_WIFI_SECURITY_MODE == WF_SECURITY_WEP_40)
#if defined(STACK_USE_UART)
    putrsUART("Set Security (WEP40)\r\n");
#endif
#elif (MY_DEFAULT_WIFI_SECURITY_MODE == WF_SECURITY_WEP_104)
#if defined(STACK_USE_UART)
    putrsUART("Set Security (WEP104)\r\n");
#endif
#elif MY_DEFAULT_WIFI_SECURITY_MODE == WF_SECURITY_WPA_WITH_KEY
#if defined(STACK_USE_UART)
    putrsUART("Set Security (WPA with key)\r\n");
#endif
#elif MY_DEFAULT_WIFI_SECURITY_MODE == WF_SECURITY_WPA2_WITH_KEY
#if defined(STACK_USE_UART)
    putrsUART("Set Security (WPA2 with key)\r\n");
#endif
#elif MY_DEFAULT_WIFI_SECURITY_MODE == WF_SECURITY_WPA_WITH_PASS_PHRASE
#if defined(STACK_USE_UART)
    putrsUART("Set Security (WPA with pass phrase)\r\n");
#endif
#elif MY_DEFAULT_WIFI_SECURITY_MODE == WF_SECURITY_WPA2_WITH_PASS_PHRASE
#if defined(STACK_USE_UART)
    putrsUART("Set Security (WPA2 with pass phrase)\r\n");
#endif
#elif MY_DEFAULT_WIFI_SECURITY_MODE == WF_SECURITY_WPA_AUTO_WITH_KEY
#if defined(STACK_USE_UART)
    putrsUART("Set Security (WPA with key, auto-select)\r\n");
#endif
#elif MY_DEFAULT_WIFI_SECURITY_MODE == WF_SECURITY_WPA_AUTO_WITH_PASS_PHRASE
#if defined(STACK_USE_UART)
    putrsUART("Set Security (WPA with pass phrase, auto-select)\r\n");
#endif
#endif /* MY_DEFAULT_WIFI_SECURITY_MODE */

    WF_CPSetSecurity(ConnectionProfileID,
            AppConfig.SecurityMode,
            AppConfig.WepKeyIndex, /* only used if WEP enabled */
            AppConfig.SecurityKey,
            AppConfig.SecurityKeyLength);

#if MY_DEFAULT_PS_POLL == WF_ENABLED
    WF_PsPollEnable(TRUE);
    if (gRFModuleVer1209orLater)
        WFEnableDeferredPowerSave();
#else
    WF_PsPollDisable();
#endif


#ifdef WF_AGGRESSIVE_PS
    if (gRFModuleVer1209orLater)
        WFEnableAggressivePowerSave();
#endif

#if defined(STACK_USE_UART)
    putrsUART("Start WiFi Connect\r\n");
#endif
    WF_CMConnect(ConnectionProfileID);
}
#endif /* WF_CS_TRIS */

// Writes an IP address to the LCD display and the UART as available

void DisplayIPValue(IP_ADDR IPVal) {
    //	printf("%u.%u.%u.%u", IPVal.v[0], IPVal.v[1], IPVal.v[2], IPVal.v[3]);
#if defined (__dsPIC33E__) || defined (__PIC24E__)
    static BYTE IPDigit[4]; /* Needs to be declared as static to avoid the array getting optimized by C30 v3.30 compiler for dsPIC33E/PIC24E.
												   Otherwise the LCD displays corrupted IP address on Explorer 16. To be fixed in the future compiler release*/
#else
    BYTE IPDigit[4];
#endif
    BYTE i;
#ifdef USE_LCD
    BYTE j;
    BYTE LCDPos = 16;
#endif

    for (i = 0; i < sizeof (IP_ADDR); i++) {
        uitoa((WORD) IPVal.v[i], IPDigit);

#if defined(STACK_USE_UART)
        putsUART1((char *) IPDigit);
#endif

#ifdef USE_LCD
        for (j = 0; j < strlen((char*) IPDigit); j++) {
            LCDText[LCDPos++] = IPDigit[j];
        }
        if (i == sizeof (IP_ADDR) - 1)
            break;
        LCDText[LCDPos++] = '.';
#else
        if (i == sizeof (IP_ADDR) - 1)
            break;
#endif

#if defined(STACK_USE_UART)
        while (BusyUART1());
        WriteUART1('.');
#endif
    }

#ifdef USE_LCD
    if (LCDPos < 32u)
        LCDText[LCDPos] = 0;
    LCDUpdate();
#endif
}

// Processes A/D data from the potentiometer

static void ProcessIO(void) {
#if defined(__C30__) || defined(__C32__)
    // Convert potentiometer result into ASCII string
    uitoa((WORD) ADC1BUF0, AN0String);
#else
    // AN0 should already be set up as an analog input
    ADCON0bits.GO = 1;

    // Wait until A/D conversion is done
    while (ADCON0bits.GO);

    // AD converter errata work around (ex: PIC18F87J10 A2)
#if !defined(__18F87J50) && !defined(_18F87J50) && !defined(__18F87J11) && !defined(_18F87J11)
    {
        BYTE temp = ADCON2;
        ADCON2 |= 0x7; // Select Frc mode by setting ADCS0/ADCS1/ADCS2
        ADCON2 = temp;
    }
#endif

    // Convert 10-bit value into ASCII string
    uitoa(*((WORD*) (&ADRESL)), AN0String);
#endif
}

/****************************************************************************
  Function:
    static void InitializeBoard(void)

  Description:
    This routine initializes the hardware.  It is a generic initialization
    routine for many of the Microchip development boards, using definitions
    in HardwareProfile.h to determine specific initialization.

  Precondition:
    None

  Parameters:
    None - None

  Returns:
    None

  Remarks:
    None
 ***************************************************************************/
static void InitializeBoard(void) {
    // LEDs
    LED0_TRIS = 0;
    LED1_TRIS = 0;
    LED2_TRIS = 0;
    LED3_TRIS = 0;
    LED4_TRIS = 0;
    LED5_TRIS = 0;
    LED6_TRIS = 0;
    LED7_TRIS = 0;
    LED_PUT(0x00);

#if defined(__PIC32MX__)
    {
        // Enable multi-vectored interrupts
        INTEnableSystemMultiVectoredInt();

        // Enable optimal performance
        //SYSTEMConfigPerformance(GetSystemClock());
        //mOSCSetPBDIV(OSC_PB_DIV_1); // Use 1:1 CPU Core:Peripheral clocks

        // Disable JTAG port so we get our I/O pins back, but first
        // wait 50ms so if you want to reprogram the part with
        // JTAG, you'll still have a tiny window before JTAG goes away.
        // The PIC32 Starter Kit debuggers use JTAG and therefore must not
        // disable JTAG.
        DelayMs(50);
#if !defined(__MPLAB_DEBUGGER_PIC32MXSK) && !defined(__MPLAB_DEBUGGER_FS2)
        DDPCONbits.JTAGEN = 0;
#endif
        LED_PUT(0x00); // Turn the LEDs off

        CNPUASET = 0x00000001; // Turn on weak pull ups on CN15, CN16, CN19 (RD5, RD7, RD13), which is connected to buttons on PIC32 Starter Kit boards
    }
#endif

    // ADC
    //AD1CON1 = 0x84E4; // Turn on, auto sample start, auto-convert, 12 bit mode (on parts with a 12bit A/D)
    //AD1CON2 = 0x0404; // AVdd, AVss, int every 2 conversions, MUXA only, scan
    //AD1CON3 = 0x1003; // 16 Tad auto-sample, Tad = 3*Tcy
#if defined(__32MX460F512L__) || defined(__32MX795F512L__)	// PIC32MX460F512L and PIC32MX795F512L PIMs has different pinout to accomodate USB module
    AD1CSSL = 1 << 2; // Scan pot
#else
    //AD1CSSL = 1 << 5; // Scan pot
#endif

    // UART
#if defined(STACK_USE_UART)

    UARTTX_TRIS = 0;
    UARTRX_TRIS = 1;
    U1MODE = 0x8000; // Set UARTEN.  Note: this must be done before setting UTXEN

    U1STA = 0x00001400; // RXEN set, TXEN set
#define CLOSEST_UBRG_VALUE ((GetPeripheralClock()+8ul*BAUD_RATE)/16/BAUD_RATE-1)
#define BAUD_ACTUAL (GetPeripheralClock()/16/(CLOSEST_UBRG_VALUE+1))

#define BAUD_ERROR ((BAUD_ACTUAL > BAUD_RATE) ? BAUD_ACTUAL-BAUD_RATE : BAUD_RATE-BAUD_ACTUAL)
#define BAUD_ERROR_PRECENT	((BAUD_ERROR*100+BAUD_RATE/2)/BAUD_RATE)
#if (BAUD_ERROR_PRECENT > 3)
#warning UART frequency error is worse than 3%
#elif (BAUD_ERROR_PRECENT > 2)
#warning UART frequency error is worse than 2%
#endif

    U1BRG = CLOSEST_UBRG_VALUE;
#endif

    // Deassert all chip select lines so there isn't any problem with
    // initialization order.  Ex: When ENC28J60 is on SPI2 with Explorer 16,
    // MAX3232 ROUT2 pin will drive RF12/U2CTS ENC28J60 CS line asserted,
    // preventing proper 25LC256 EEPROM operation.
#if defined(ENC_CS_TRIS)
    ENC_CS_IO = 1;
    ENC_CS_TRIS = 0;
#endif
#if defined(ENC100_CS_TRIS)
    ENC100_CS_IO = (ENC100_INTERFACE_MODE == 0);
    ENC100_CS_TRIS = 0;
#endif
#if defined(EEPROM_CS_TRIS)
    EEPROM_CS_IO = 1;
    EEPROM_CS_TRIS = 0;
#endif
#if defined(SPIRAM_CS_TRIS)
    SPIRAM_CS_IO = 1;
    SPIRAM_CS_TRIS = 0;
#endif
#if defined(SPIFLASH_CS_TRIS)
    SPIFLASH_CS_IO = 1;
    SPIFLASH_CS_TRIS = 0;
#endif
#if defined(WF_CS_TRIS)
    WF_CS_IO = 1;
    WF_CS_TRIS = 0;
#endif

#if defined(DSPICDEM11)
    // Deselect the LCD controller (PIC18F252 onboard) to ensure there is no SPI2 contention
    LCDCTRL_CS_TRIS = 0;
    LCDCTRL_CS_IO = 1;

    // Hold the codec in reset to ensure there is no SPI2 contention
    CODEC_RST_TRIS = 0;
    CODEC_RST_IO = 0;
#endif

#if defined(SPIRAM_CS_TRIS)
    SPIRAMInit();
#endif
#if defined(EEPROM_CS_TRIS)
    XEEInit();
#endif
#if defined(SPIFLASH_CS_TRIS)
    SPIFlashInit();
#endif
}

/*********************************************************************
 * Function:        void InitAppConfig(void)
 *
 * PreCondition:    MPFSInit() is already called.
 *
 * Input:           None
 *
 * Output:          Write/Read non-volatile config variables.
 *
 * Side Effects:    None
 *
 * Overview:        None
 *
 * Note:            None
 ********************************************************************/
// MAC Address Serialization using a MPLAB PM3 Programmer and
// Serialized Quick Turn Programming (SQTP).
// The advantage of using SQTP for programming the MAC Address is it
// allows you to auto-increment the MAC address without recompiling
// the code for each unit.  To use SQTP, the MAC address must be fixed
// at a specific location in program memory.  Uncomment these two pragmas
// that locate the MAC address at 0x1FFF0.  Syntax below is for MPLAB C
// Compiler for PIC18 MCUs. Syntax will vary for other compilers.
//#pragma romdata MACROM=0x1FFF0
static ROM BYTE SerializedMACAddress[6] = {MY_DEFAULT_MAC_BYTE1, MY_DEFAULT_MAC_BYTE2, MY_DEFAULT_MAC_BYTE3, MY_DEFAULT_MAC_BYTE4, MY_DEFAULT_MAC_BYTE5, MY_DEFAULT_MAC_BYTE6};
//#pragma romdata

static void InitAppConfig(void) {
#if defined(EEPROM_CS_TRIS) || defined(SPIFLASH_CS_TRIS)
    unsigned char vNeedToSaveDefaults = 0;
#endif

    while (1) {
        // Start out zeroing all AppConfig bytes to ensure all fields are
        // deterministic for checksum generation
        memset((void*) &AppConfig, 0x00, sizeof (AppConfig));

        AppConfig.Flags.bIsDHCPEnabled = TRUE;
        AppConfig.Flags.bInConfigMode = TRUE;
        memcpypgm2ram((void*) &AppConfig.MyMACAddr, (ROM void*) SerializedMACAddress, sizeof (AppConfig.MyMACAddr));
        //		{
        //			_prog_addressT MACAddressAddress;
        //			MACAddressAddress.next = 0x157F8;
        //			_memcpy_p2d24((char*)&AppConfig.MyMACAddr, MACAddressAddress, sizeof(AppConfig.MyMACAddr));
        //		}
        AppConfig.MyIPAddr.Val = MY_DEFAULT_IP_ADDR_BYTE1 | MY_DEFAULT_IP_ADDR_BYTE2 << 8ul | MY_DEFAULT_IP_ADDR_BYTE3 << 16ul | MY_DEFAULT_IP_ADDR_BYTE4 << 24ul;
        AppConfig.DefaultIPAddr.Val = AppConfig.MyIPAddr.Val;
        AppConfig.MyMask.Val = MY_DEFAULT_MASK_BYTE1 | MY_DEFAULT_MASK_BYTE2 << 8ul | MY_DEFAULT_MASK_BYTE3 << 16ul | MY_DEFAULT_MASK_BYTE4 << 24ul;
        AppConfig.DefaultMask.Val = AppConfig.MyMask.Val;
        AppConfig.MyGateway.Val = MY_DEFAULT_GATE_BYTE1 | MY_DEFAULT_GATE_BYTE2 << 8ul | MY_DEFAULT_GATE_BYTE3 << 16ul | MY_DEFAULT_GATE_BYTE4 << 24ul;
        AppConfig.PrimaryDNSServer.Val = MY_DEFAULT_PRIMARY_DNS_BYTE1 | MY_DEFAULT_PRIMARY_DNS_BYTE2 << 8ul | MY_DEFAULT_PRIMARY_DNS_BYTE3 << 16ul | MY_DEFAULT_PRIMARY_DNS_BYTE4 << 24ul;
        AppConfig.SecondaryDNSServer.Val = MY_DEFAULT_SECONDARY_DNS_BYTE1 | MY_DEFAULT_SECONDARY_DNS_BYTE2 << 8ul | MY_DEFAULT_SECONDARY_DNS_BYTE3 << 16ul | MY_DEFAULT_SECONDARY_DNS_BYTE4 << 24ul;

        // SNMP Community String configuration
#if defined(STACK_USE_SNMP_SERVER)
        {
            BYTE i;
            static ROM char * ROM cReadCommunities[] = SNMP_READ_COMMUNITIES;
            static ROM char * ROM cWriteCommunities[] = SNMP_WRITE_COMMUNITIES;
            ROM char * strCommunity;

            for (i = 0; i < SNMP_MAX_COMMUNITY_SUPPORT; i++) {
                // Get a pointer to the next community string
                strCommunity = cReadCommunities[i];
                if (i >= sizeof (cReadCommunities) / sizeof (cReadCommunities[0]))
                    strCommunity = "";

                // Ensure we don't buffer overflow.  If your code gets stuck here,
                // it means your SNMP_COMMUNITY_MAX_LEN definition in TCPIPConfig.h
                // is either too small or one of your community string lengths
                // (SNMP_READ_COMMUNITIES) are too large.  Fix either.
                if (strlenpgm(strCommunity) >= sizeof (AppConfig.readCommunity[0]))
                    while (1);

                // Copy string into AppConfig
                strcpypgm2ram((char*) AppConfig.readCommunity[i], strCommunity);

                // Get a pointer to the next community string
                strCommunity = cWriteCommunities[i];
                if (i >= sizeof (cWriteCommunities) / sizeof (cWriteCommunities[0]))
                    strCommunity = "";

                // Ensure we don't buffer overflow.  If your code gets stuck here,
                // it means your SNMP_COMMUNITY_MAX_LEN definition in TCPIPConfig.h
                // is either too small or one of your community string lengths
                // (SNMP_WRITE_COMMUNITIES) are too large.  Fix either.
                if (strlenpgm(strCommunity) >= sizeof (AppConfig.writeCommunity[0]))
                    while (1);

                // Copy string into AppConfig
                strcpypgm2ram((char*) AppConfig.writeCommunity[i], strCommunity);
            }
        }
#endif

        // Load the default NetBIOS Host Name
        memcpypgm2ram(AppConfig.NetBIOSName, (ROM void*) MY_DEFAULT_HOST_NAME, 16);
        FormatNetBIOSName(AppConfig.NetBIOSName);

#if defined(WF_CS_TRIS)
        // Load the default SSID Name
        WF_ASSERT(sizeof (MY_DEFAULT_SSID_NAME) <= sizeof (AppConfig.MySSID));
        memcpypgm2ram(AppConfig.MySSID, (ROM void*) MY_DEFAULT_SSID_NAME, sizeof (MY_DEFAULT_SSID_NAME));
        AppConfig.SsidLength = sizeof (MY_DEFAULT_SSID_NAME) - 1;

        AppConfig.SecurityMode = MY_DEFAULT_WIFI_SECURITY_MODE;
        AppConfig.WepKeyIndex = MY_DEFAULT_WEP_KEY_INDEX;

#if (MY_DEFAULT_WIFI_SECURITY_MODE == WF_SECURITY_OPEN)
        memset(AppConfig.SecurityKey, 0x00, sizeof (AppConfig.SecurityKey));
        AppConfig.SecurityKeyLength = 0;

#elif MY_DEFAULT_WIFI_SECURITY_MODE == WF_SECURITY_WEP_40
        memcpypgm2ram(AppConfig.SecurityKey, (ROM void*) MY_DEFAULT_WEP_KEYS_40, sizeof (MY_DEFAULT_WEP_KEYS_40) - 1);
        AppConfig.SecurityKeyLength = sizeof (MY_DEFAULT_WEP_KEYS_40) - 1;

#elif MY_DEFAULT_WIFI_SECURITY_MODE == WF_SECURITY_WEP_104
        memcpypgm2ram(AppConfig.SecurityKey, (ROM void*) MY_DEFAULT_WEP_KEYS_104, sizeof (MY_DEFAULT_WEP_KEYS_104) - 1);
        AppConfig.SecurityKeyLength = sizeof (MY_DEFAULT_WEP_KEYS_104) - 1;

#elif (MY_DEFAULT_WIFI_SECURITY_MODE == WF_SECURITY_WPA_WITH_KEY)       || \
	              (MY_DEFAULT_WIFI_SECURITY_MODE == WF_SECURITY_WPA2_WITH_KEY)      || \
	              (MY_DEFAULT_WIFI_SECURITY_MODE == WF_SECURITY_WPA_AUTO_WITH_KEY)
        memcpypgm2ram(AppConfig.SecurityKey, (ROM void*) MY_DEFAULT_PSK, sizeof (MY_DEFAULT_PSK) - 1);
        AppConfig.SecurityKeyLength = sizeof (MY_DEFAULT_PSK) - 1;

#elif (MY_DEFAULT_WIFI_SECURITY_MODE == WF_SECURITY_WPA_WITH_PASS_PHRASE)     || \
	              (MY_DEFAULT_WIFI_SECURITY_MODE == WF_SECURITY_WPA2_WITH_PASS_PHRASE)    || \
	              (MY_DEFAULT_WIFI_SECURITY_MODE == WF_SECURITY_WPA_AUTO_WITH_PASS_PHRASE)
        memcpypgm2ram(AppConfig.SecurityKey, (ROM void*) MY_DEFAULT_PSK_PHRASE, sizeof (MY_DEFAULT_PSK_PHRASE) - 1);
        AppConfig.SecurityKeyLength = sizeof (MY_DEFAULT_PSK_PHRASE) - 1;

#else
#error "No security defined"
#endif /* MY_DEFAULT_WIFI_SECURITY_MODE */

#endif

        // Compute the checksum of the AppConfig defaults as loaded from ROM
        wOriginalAppConfigChecksum = CalcIPChecksum((BYTE*) & AppConfig, sizeof (AppConfig));

#if defined(EEPROM_CS_TRIS) || defined(SPIFLASH_CS_TRIS)
        {
            NVM_VALIDATION_STRUCT NVMValidationStruct;

            // Check to see if we have a flag set indicating that we need to
            // save the ROM default AppConfig values.
            if (vNeedToSaveDefaults)
                SaveAppConfig(&AppConfig);

            // Read the NVMValidation record and AppConfig struct out of EEPROM/Flash
#if defined(EEPROM_CS_TRIS)
            {
                XEEReadArray(0x0000, (BYTE*) & NVMValidationStruct, sizeof (NVMValidationStruct));
                XEEReadArray(sizeof (NVMValidationStruct), (BYTE*) & AppConfig, sizeof (AppConfig));
            }
#elif defined(SPIFLASH_CS_TRIS)
            {
                SPIFlashReadArray(0x0000, (BYTE*) & NVMValidationStruct, sizeof (NVMValidationStruct));
                SPIFlashReadArray(sizeof (NVMValidationStruct), (BYTE*) & AppConfig, sizeof (AppConfig));
            }
#endif

            // Check EEPROM/Flash validitity.  If it isn't valid, set a flag so
            // that we will save the ROM default values on the next loop
            // iteration.
            if ((NVMValidationStruct.wConfigurationLength != sizeof (AppConfig)) ||
                    (NVMValidationStruct.wOriginalChecksum != wOriginalAppConfigChecksum) ||
                    (NVMValidationStruct.wCurrentChecksum != CalcIPChecksum((BYTE*) & AppConfig, sizeof (AppConfig)))) {
                // Check to ensure that the vNeedToSaveDefaults flag is zero,
                // indicating that this is the first iteration through the do
                // loop.  If we have already saved the defaults once and the
                // EEPROM/Flash still doesn't pass the validity check, then it
                // means we aren't successfully reading or writing to the
                // EEPROM/Flash.  This means you have a hardware error and/or
                // SPI configuration error.
                if (vNeedToSaveDefaults) {
                    while (1);
                }

                // Set flag and restart loop to load ROM defaults and save them
                vNeedToSaveDefaults = 1;
                continue;
            }

            // If we get down here, it means the EEPROM/Flash has valid contents
            // and either matches the ROM defaults or previously matched and
            // was run-time reconfigured by the user.  In this case, we shall
            // use the contents loaded from EEPROM/Flash.
            break;
        }
#endif
        break;
    }
}

#if defined(EEPROM_CS_TRIS) || defined(SPIFLASH_CS_TRIS)

void SaveAppConfig(const APP_CONFIG *ptrAppConfig) {
    NVM_VALIDATION_STRUCT NVMValidationStruct;

    // Ensure adequate space has been reserved in non-volatile storage to
    // store the entire AppConfig structure.  If you get stuck in this while(1)
    // trap, it means you have a design time misconfiguration in TCPIPConfig.h.
    // You must increase MPFS_RESERVE_BLOCK to allocate more space.
#if defined(STACK_USE_MPFS2)
    if (sizeof (NVMValidationStruct) + sizeof (AppConfig) > MPFS_RESERVE_BLOCK)
        while (1);
#endif

    // Get proper values for the validation structure indicating that we can use
    // these EEPROM/Flash contents on future boot ups
    NVMValidationStruct.wOriginalChecksum = wOriginalAppConfigChecksum;
    NVMValidationStruct.wCurrentChecksum = CalcIPChecksum((BYTE*) ptrAppConfig, sizeof (APP_CONFIG));
    NVMValidationStruct.wConfigurationLength = sizeof (APP_CONFIG);

    // Write the validation struct and current AppConfig contents to EEPROM/Flash
#if defined(EEPROM_CS_TRIS)
    XEEBeginWrite(0x0000);
    XEEWriteArray((BYTE*) & NVMValidationStruct, sizeof (NVMValidationStruct));
    XEEWriteArray((BYTE*) ptrAppConfig, sizeof (APP_CONFIG));
#else
    SPIFlashBeginWrite(0x0000);
    SPIFlashWriteArray((BYTE*) & NVMValidationStruct, sizeof (NVMValidationStruct));
    SPIFlashWriteArray((BYTE*) ptrAppConfig, sizeof (APP_CONFIG));
#endif
}
#endif
