whiteway11890/PIC32_Dev/Firmware/Ethernet/src/DHCP.c

/*********************************************************************
*
*	Dynamic Host Configuration Protocol (DHCP) Client
*	Module for Microchip TCP/IP Stack
*	 -Provides automatic IP address, subnet mask, gateway address, 
*	  DNS server address, and other configuration parameters on DHCP 
*	  enabled networks.
*	 -Reference: RFC 2131, 2132
*
*********************************************************************
* FileName:		DHCP.c
* Dependencies:	UDP
* Processor:	PIC18, PIC24F, PIC24H, dsPIC30F, dsPIC33F, PIC32
* Compiler:		Microchip C32 v1.05 or higher
*				Microchip C30 v3.12 or higher
*				Microchip C18 v3.30 or higher
*				HI-TECH PICC-18 PRO 9.63PL2 or higher
* Company:		Microchip Technology, Inc.
*
* Software License Agreement
*
* Copyright (C) 2002-2009 Microchip Technology Inc.  All rights
* reserved.
*
* Microchip licenses to you the right to use, modify, copy, and
* distribute:
* (i)  the Software when embedded on a Microchip microcontroller or
*      digital signal controller product ("Device") which is
*      integrated into Licensee's product; or
* (ii) ONLY the Software driver source files ENC28J60.c, ENC28J60.h,
*		ENCX24J600.c and ENCX24J600.h ported to a non-Microchip device
*		used in conjunction with a Microchip ethernet controller for
*		the sole purpose of interfacing with the ethernet controller.
*
* You should refer to the license agreement accompanying this
* Software for additional information regarding your rights and
* obligations.
*
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
*
* Author               Date    Comment
*~~~~~~~~~~~~~~~~~~~~~~~~~~~~~~~~~~~~~~~~~~~~~~~~~~~~~~~~~~~~~~~~~~~~
* Nilesh Rajbharti     3/21/01  Original        (Rev 1.0)
* Nilesh Rajbharti     7/10/02  Explicitly initialized tempIPAddress
*                                               (Rev 2.11)
* Nilesh Rajbharti     5/16/03 Increased DHCP_TIMEOUT to 2 seconds.
* Nilesh Rajbharti     5/16/03 Fixed SM_DHCP_BROADCAST logic
*                              where UDPPut was called before setting
*                              active socket.
* Robert Sloan         5/29/03 Improved DHCP State machine to handle
*                              NAK and renew existing IP address.
* Nilesh Rajbharti     8/15/03 Modified _DHCPRecieve() to check for
*                              chaddr field before accpting the packet.
*                              Fixed DHCPTask() where it would not
*                              reply to first OFFER.
* Nilesh Rajbharti     3/1/04  Used tickDiff in DHCPTask() "bind"
*                              state to adjust for irregular TICK_SECOND
*                              Without this logic, actual lease time count
*                              down may be incorrect.
* Howard Schlunder		5/11/06	Fixed tickDiff usage, reducing 
*								accumulated timing error.  Fixed DHCP 
*								state machine requesting IP 0.0.0.0 
*								after lease expiration.
* Howard Schlunder		6/01/06	Added DHCPFlags.bits.bOfferReceived flag to 
*								allow operation on networks with multiple
*								DHCP servers offering multiple addresses
* Howard Schlunder		8/01/06 Added DNS server option to DHCP request, 
*								untested Host Name option to DHCP request
* Howard Schlunder		1/09/06	Fixed a DHCP renewal not renewing lease time bug
* Howard Schlunder		3/16/07 Rewrote DHCP state machine
********************************************************************/
#define __DHCP_C

#include "TCPIPConfig.h"

#if defined(STACK_USE_DHCP_CLIENT)

#include "TCPIP.h"

// Defines how long to wait before a DHCP request times out
#define DHCP_TIMEOUT				(2ul*TICK_SECOND)

// Unique variables per interface
typedef struct
{
	UDP_SOCKET			hDHCPSocket;	// Handle to DHCP client socket
	SM_DHCP				smState;		// DHCP client state machine variable
	union
	{
	    struct
	    {
	        unsigned char bIsBound : 1;				// Whether or not DHCP is currently bound
	        unsigned char bEvent : 1;				// Indicates to an external module that the DHCP client has been reset, has obtained new parameters via the DHCP client, or has refreshed a lease on existing ones
	        unsigned char bOfferReceived : 1;		// Whether or not an offer has been received
			unsigned char bDHCPServerDetected : 1;	// Indicates if a DCHP server has been detected
			unsigned char bUseUnicastMode : 1;		// Indicates if the 
	    } bits;
	    BYTE val;
	} flags;
	DWORD 				dwTimer;		// Tick timer value used for triggering future events after a certain wait period.
	DWORD				dwLeaseTime;	// DHCP lease time remaining, in seconds
	DWORD				dwServerID;		// DHCP Server ID cache
	IP_ADDR				tempIPAddress;	// Temporary IP address to use when no DHCP lease
	IP_ADDR				tempGateway;	// Temporary gateway to use when no DHCP lease
	IP_ADDR				tempMask;		// Temporary mask to use when no DHCP lease
	#if defined(STACK_USE_DNS)
	IP_ADDR				tempDNS;		// Temporary primary DNS server
	IP_ADDR				tempDNS2;		// Temporary secondary DNS server
	#endif	
	// Indicates which DHCP values are currently valid
	union
	{
		struct
		{
			char IPAddress:1;	// Leased IP address is valid
			char Gateway:1;		// Gateway address is valid
			char Mask:1;		// Subnet mask is valid
			char DNS:1;			// Primary DNS is valid
			char DNS2:1;		// Secondary DNS is valid
			char HostName:1;	// Host name is valid (not implemented)
		} bits;
		BYTE val;
	} validValues;
} DHCP_CLIENT_VARS;

BOOL DHCPClientInitializedOnce = FALSE;

static BYTE _DHCPReceive(void);
static void _DHCPSend(BYTE messageType, BOOL bRenewing);

#if defined (WF_CS_IO)
extern void SignalDHCPSuccessful(void);
#endif


/*****************************************************************************
  Function:
	static void LoadState(BYTE vInterface)

  Summary:
	Saves the DHCPClient state information structure to the appropriate 
	location and loads DHCPClient with the state information for the specified 
	interface.

  Description:
	Saves the DHCPClient state information structure to the appropriate 
	location and loads DHCPClient with the state information for the specified 
	interface.

  Precondition:
	None

  Parameters:
	None

  Returns:
	None

  Remarks:
  	This function does nothing when you only have one physical interface.
***************************************************************************/
#if NETWORK_INTERFACES > 1

static DHCP_CLIENT_VARS	DHCPClients[NETWORK_INTERFACES];
static DHCP_CLIENT_VARS	*SelectedDHCPClient;
#define DHCPClient		(*SelectedDHCPClient)
#define LoadState(v)	do(SelectedDHCPClient = &DHCPClients[v])while(0)

#else

static DHCP_CLIENT_VARS DHCPClient;
#define LoadState(v)

#endif


/*****************************************************************************
  Function:
	void DHCPInit(BYTE vInterface)

  Summary:
	Resets the DHCP client module for the specified interface.

  Description:
	Resets the DHCP client module, giving up any current lease, knowledge of 
	DHCP servers, etc. for the specified interface.

  Precondition:
	None

  Parameters:
	vInterface - Interface number to initialize DHCP client state variables 
		for.   If you only have one interface, specify 0x00.

  Returns:
	None

  Remarks:
	This function may be called multiple times throughout the life of the 
	application, if desired.  
***************************************************************************/
void DHCPInit(BYTE vInterface)
{
	BYTE i;
	
	// Upon the first call after POR, we must reset all handles to invalid so 
	// that we don't inadvertently close someone else's handle.
	if(!DHCPClientInitializedOnce)
	{
		DHCPClientInitializedOnce = TRUE;
		for(i = 0; i < NETWORK_INTERFACES; i++)
		{
			LoadState(i);
			DHCPClient.hDHCPSocket = INVALID_UDP_SOCKET;
		}		
	}
	
	
	LoadState(vInterface);
	
	if(DHCPClient.hDHCPSocket != INVALID_UDP_SOCKET)
	{
		UDPClose(DHCPClient.hDHCPSocket);
		DHCPClient.hDHCPSocket = INVALID_UDP_SOCKET;
	}

	// Reset state machine and flags to default values
	DHCPClient.smState = SM_DHCP_GET_SOCKET;
	DHCPClient.flags.val = 0;
	DHCPClient.flags.bits.bUseUnicastMode = TRUE;	// This flag toggles before use, so this statement actually means to start out using broadcast mode.
	DHCPClient.flags.bits.bEvent = TRUE;
}


/*****************************************************************************
  Function:
	void DHCPDisable(BYTE vInterface)

  Summary:
	Disables the DHCP Client for the specified interface.

  Description:
	Disables the DHCP client for the specified interface by sending the state 
	machine to "SM_DHCP_DISABLED".  If the interface was previously configured 
	by DHCP, the configuration will continue to be used but the module will no 
	longer preform any renewals.

  Precondition:
	None

  Parameters:
	vInterface - Interface number to disable the DHCP client on.   If you only 
		have one interface, specify 0x00.

  Returns:
	None

  Remarks:
	Since the interface continues using its old configuration, it is possible 
	that the lease may expire and the DHCP server provide the IP to another
	client.  The application should replace the current IP address and other
	configuration with static information following a call to this function.
***************************************************************************/
void DHCPDisable(BYTE vInterface)
{
	LoadState(vInterface);

	if(DHCPClient.hDHCPSocket != INVALID_UDP_SOCKET)
	{
		UDPClose(DHCPClient.hDHCPSocket);
		DHCPClient.hDHCPSocket = INVALID_UDP_SOCKET;
	}

	DHCPClient.smState = SM_DHCP_DISABLED;
}


/*****************************************************************************
  Function:
	void DHCPEnable(BYTE vInterface)

  Summary:
	Enables the DHCP client for the specified interface.

  Description:
	Enables the DHCP client for the specified interface, if it is disabled.  
	If it is already enabled, nothing is done.

  Precondition:
	None

  Parameters:
	vInterface - Interface number to enable the DHCP client on.   If you only 
		have one interface, specify 0x00.

  Returns:
	None
***************************************************************************/
void DHCPEnable(BYTE vInterface)
{
	LoadState(vInterface);

	if(DHCPClient.smState == SM_DHCP_DISABLED)
	{
		DHCPClient.smState = SM_DHCP_GET_SOCKET;
		DHCPClient.flags.bits.bIsBound = FALSE;
	}
}

/*****************************************************************************
  Function:
	BOOL DHCPIsEnabled(BYTE vInterface)

  Summary:
	Determins if the DHCP client is enabled on the specified interface.

  Description:
	Determins if the DHCP client is enabled on the specified interface.

  Precondition:
	None

  Parameters:
	vInterface - Interface number to query.   If you only have one interface, 
		specify 0x00.

  Returns:
	None
***************************************************************************/
BOOL DHCPIsEnabled(BYTE vInterface)
{
	LoadState(vInterface);
	return DHCPClient.smState != SM_DHCP_DISABLED;
}


/*****************************************************************************
  Function:
	BOOL DHCPIsBound(BYTE vInterface)

  Summary:
	Determins if the DHCP client has an IP address lease on the specified 
	interface.

  Description:
	Determins if the DHCP client has an IP address lease on the specified 
	interface.

  Precondition:
	None

  Parameters:
	vInterface - Interface number to query.   If you only have one interface, 
		specify 0x00.

  Returns:
	TRUE - DHCP client has obtained an IP address lease (and likely other 
		parameters) and these values are currently being used.
	FALSE - No IP address is currently leased
***************************************************************************/
BOOL DHCPIsBound(BYTE vInterface)
{
	LoadState(vInterface);
	return DHCPClient.flags.bits.bIsBound;
}

/*****************************************************************************
  Function:
	BOOL DHCPStateChanged(BYTE vInterface)

  Summary:
	Determins if the DHCP client on the specified interface has changed states 
	or refreshed its IP address lease.

  Description:
	Determins if the DHCP client on the specified interface has changed states 
	or refreshed its IP address lease.  This function can be used to determine
	when to update an LCD or other display whenever the DHCP assigned IP 
	address has potentially changed.
	
  Precondition:
	None

  Parameters:
	vInterface - Interface number to query.   If you only have one interface, 
		specify 0x00.

  Returns:
	TRUE - The IP address lease have been reliquished (due to reinitilization), 
		obtained (first event), or renewed since the last call to 
		DHCPStateChanged().
	FALSE - The DHCP client has not detected any changes since the last call to 
		DHCPStateChanged().
***************************************************************************/
BOOL DHCPStateChanged(BYTE vInterface)
{
	LoadState(vInterface);
	if(DHCPClient.flags.bits.bEvent)
	{
		DHCPClient.flags.bits.bEvent = 0;
		return TRUE;
	}
	return FALSE;
}


/*****************************************************************************
  Function:
	BOOL DHCPIsServerDetected(BYTE vInterface)

  Summary:
	Determins if the DHCP client on the specified interface has seen a DHCP 
	server.

  Description:
	Determins if the DHCP client on the specified interface has seen a DHCP 
	server.
	
  Precondition:
	None

  Parameters:
	vInterface - Interface number to query.   If you only have one interface, 
		specify 0x00.

  Returns:
	TRUE - At least one DHCP server is attached to the specified network 
		interface.
	FALSE - No DHCP servers are currently detected on the specified network 
		interface.
***************************************************************************/
BOOL DHCPIsServerDetected(BYTE vInterface)
{
	LoadState(vInterface);
	return DHCPClient.flags.bits.bDHCPServerDetected;
}


/*****************************************************************************
  Function:
	void DHCPTask(void)

  Summary:
	Performs periodic DHCP tasks for all interfaces.

  Description:
	This function performs any periodic tasks requied by the DHCP module, 
	such as sending and receiving messages involved with obtaining and
	maintaining a lease.

  Precondition:
	None

  Parameters:
	None

  Returns:
	None
***************************************************************************/
void DHCPTask(void)
{
	BYTE i;
	
	for(i = 0; i < NETWORK_INTERFACES; i++)
	{
		LoadState(i);
		switch(DHCPClient.smState)
		{
			case SM_DHCP_DISABLED:
				// When the module is disabled, do absolutely nothing
				break;
			
			case SM_DHCP_GET_SOCKET:
				// Open a socket to send and receive broadcast messages on
				//DHCPClient.hDHCPSocket = UDPOpen(DHCP_CLIENT_PORT, NULL, DHCP_SERVER_PORT);
				
				DHCPClient.hDHCPSocket = UDPOpenEx(0,UDP_OPEN_SERVER,DHCP_CLIENT_PORT, DHCP_SERVER_PORT);
				if(DHCPClient.hDHCPSocket == INVALID_UDP_SOCKET)
					break;
	
				DHCPClient.smState = SM_DHCP_SEND_DISCOVERY;
				// No break
	
			case SM_DHCP_SEND_DISCOVERY:
				// Assume default IP Lease time of 60 seconds.
				// This should be minimum possible to make sure that if the
				// server did not specify lease time, we try again after this 
				// minimum time.
				DHCPClient.dwLeaseTime = 60;
				DHCPClient.validValues.val = 0x00;
				DHCPClient.flags.bits.bIsBound = FALSE;	
				DHCPClient.flags.bits.bOfferReceived = FALSE;
	
				// No point in wasting time transmitting a discovery if we are 
				// unlinked.  No one will see it.  
				if(!MACIsLinked())
					break;
					
            	#if defined(WF_CS_IO)
            	    #if defined(STACK_USE_UART )
            	        putrsUART("DHCP Send Discovery...\r\n");
            	    #endif
            	#endif
	
				// Ensure transmitter is ready to accept data
				if(UDPIsPutReady(DHCPClient.hDHCPSocket) < 300u)
					break;

				// Toggle the BOOTP Broadcast flag to ensure compatibility with 
				// bad DHCP servers that don't know how to handle broadcast 
				// responses.  This results in the next discovery attempt to be 
				// made using the opposite mode.
				DHCPClient.flags.bits.bUseUnicastMode ^= 1;
	
				// Ensure that we transmit to the broadcast IP and MAC addresses
				// The UDP Socket remembers who it was last talking to
				memset((void*)&UDPSocketInfo[DHCPClient.hDHCPSocket].remote.remoteNode, 0xFF, sizeof(UDPSocketInfo[0].remote.remoteNode));
	
				// Send the DHCP Discover broadcast
				_DHCPSend(DHCP_DISCOVER_MESSAGE, FALSE);
	
				// Start a timer and begin looking for a response
				DHCPClient.dwTimer = TickGet();
				DHCPClient.smState = SM_DHCP_GET_OFFER;
				break;
	
			case SM_DHCP_GET_OFFER:
				// Check to see if a packet has arrived
				if(UDPIsGetReady(DHCPClient.hDHCPSocket) < 250u)
				{
					// Go back and transmit a new discovery if we didn't get an offer after 2 seconds
					if(TickGet() - DHCPClient.dwTimer >= DHCP_TIMEOUT)
						DHCPClient.smState = SM_DHCP_SEND_DISCOVERY;
					break;
				}
	
				// Let the DHCP server module know that there is a DHCP server 
				// on this network
				DHCPClient.flags.bits.bDHCPServerDetected = TRUE;
	
				// Check to see if we received an offer
				if(_DHCPReceive() != DHCP_OFFER_MESSAGE)
					break;
	
				DHCPClient.smState = SM_DHCP_SEND_REQUEST;
				// No break
	
			case SM_DHCP_SEND_REQUEST:
				if(UDPIsPutReady(DHCPClient.hDHCPSocket) < 258u)
					break;

				// Ensure that we transmit to the broadcast IP and MAC addresses
				// The UDP Socket remembers who it was last talking to, so 
				// we must set this back to the broadcast address since the 
				// current socket values are the unicast addresses of the DHCP 
				// server.
				memset((void*)&UDPSocketInfo[DHCPClient.hDHCPSocket].remote.remoteNode, 0xFF, sizeof(UDPSocketInfo[0].remote.remoteNode));
	
				// Send the DHCP request message
				_DHCPSend(DHCP_REQUEST_MESSAGE, FALSE);
	
				// Start a timer and begin looking for a response
				DHCPClient.dwTimer = TickGet();
				DHCPClient.smState = SM_DHCP_GET_REQUEST_ACK;
				break;
	
			case SM_DHCP_GET_REQUEST_ACK:
				// Check to see if a packet has arrived
				if(UDPIsGetReady(DHCPClient.hDHCPSocket) < 250u)
				{
					// Go back and transmit a new discovery if we didn't get an ACK after 2 seconds
					if(TickGet() - DHCPClient.dwTimer >= DHCP_TIMEOUT)
						DHCPClient.smState = SM_DHCP_SEND_DISCOVERY;
					break;
				}
	
				// Check to see if we received an offer
				switch(_DHCPReceive())
				{
					case DHCP_ACK_MESSAGE:
						UDPClose(DHCPClient.hDHCPSocket);
						DHCPClient.hDHCPSocket = INVALID_UDP_SOCKET;
						DHCPClient.dwTimer = TickGet();
						DHCPClient.smState = SM_DHCP_BOUND;
						DHCPClient.flags.bits.bEvent = 1;
						DHCPClient.flags.bits.bIsBound = TRUE;	

						if(DHCPClient.validValues.bits.IPAddress)
						{
							AppConfig.MyIPAddr = DHCPClient.tempIPAddress;
							#if defined(WF_CS_IO) 
							    #if defined(STACK_USE_UART )
							        putrsUART("DHCP client successful\r\n");
							    #endif
    							SignalDHCPSuccessful();
							#endif
						}	
						if(DHCPClient.validValues.bits.Mask)
							AppConfig.MyMask = DHCPClient.tempMask;
						if(DHCPClient.validValues.bits.Gateway)
							AppConfig.MyGateway = DHCPClient.tempGateway;
						#if defined(STACK_USE_DNS)
							if(DHCPClient.validValues.bits.DNS)
								AppConfig.PrimaryDNSServer.Val = DHCPClient.tempDNS.Val;
							AppConfig.SecondaryDNSServer.Val = 0x00000000ul;
							if(DHCPClient.validValues.bits.DNS2)
								AppConfig.SecondaryDNSServer.Val = DHCPClient.tempDNS2.Val;
						#endif
						//if(DHCPClient.validValues.bits.HostName)
						//	memcpy(AppConfig.NetBIOSName, (void*)DHCPClient.tempHostName, sizeof(AppConfig.NetBIOSName));
	
						break;
	
					case DHCP_NAK_MESSAGE:
						DHCPClient.smState = SM_DHCP_SEND_DISCOVERY;
						break;
				}
				break;
	
			case SM_DHCP_BOUND:
				if(TickGet() - DHCPClient.dwTimer < TICK_SECOND)
					break;
	
				// Check to see if our lease is still valid, if so, decrement lease 
				// time
				if(DHCPClient.dwLeaseTime >= 2ul)
				{
					DHCPClient.dwTimer += TICK_SECOND;
					DHCPClient.dwLeaseTime--;
					break;
				}
	
				// Open a socket to send and receive DHCP messages on
				//DHCPClient.hDHCPSocket = UDPOpen(DHCP_CLIENT_PORT, NULL, DHCP_SERVER_PORT);
				
				DHCPClient.hDHCPSocket = UDPOpenEx(0,UDP_OPEN_SERVER,DHCP_CLIENT_PORT, DHCP_SERVER_PORT);
				if(DHCPClient.hDHCPSocket == INVALID_UDP_SOCKET)
					break;
	
				DHCPClient.smState = SM_DHCP_SEND_RENEW;
				// No break
	
			case SM_DHCP_SEND_RENEW:
			case SM_DHCP_SEND_RENEW2:
			case SM_DHCP_SEND_RENEW3:
				if(UDPIsPutReady(DHCPClient.hDHCPSocket) < 258u)
					break;
	
				// Send the DHCP request message
				_DHCPSend(DHCP_REQUEST_MESSAGE, TRUE);
				DHCPClient.flags.bits.bOfferReceived = FALSE;
	
				// Start a timer and begin looking for a response
				DHCPClient.dwTimer = TickGet();
				DHCPClient.smState++;
				break;
	
			case SM_DHCP_GET_RENEW_ACK:
			case SM_DHCP_GET_RENEW_ACK2:
			case SM_DHCP_GET_RENEW_ACK3:
				// Check to see if a packet has arrived
				if(UDPIsGetReady(DHCPClient.hDHCPSocket) < 250u)
				{
					// Go back and transmit a new discovery if we didn't get an ACK after 2 seconds
					if(TickGet() - DHCPClient.dwTimer >=  DHCP_TIMEOUT)
					{
						if(++DHCPClient.smState > SM_DHCP_GET_RENEW_ACK3)
							DHCPClient.smState = SM_DHCP_SEND_DISCOVERY;
					}
					break;
				}
	
				// Check to see if we received an offer
				switch(_DHCPReceive())
				{
					case DHCP_ACK_MESSAGE:
						UDPClose(DHCPClient.hDHCPSocket);
						DHCPClient.hDHCPSocket = INVALID_UDP_SOCKET;
						DHCPClient.dwTimer = TickGet();
						DHCPClient.smState = SM_DHCP_BOUND;
						DHCPClient.flags.bits.bEvent = 1;
						break;
		
					case DHCP_NAK_MESSAGE:
						DHCPClient.smState = SM_DHCP_SEND_DISCOVERY;
						break;
				}
				break;
		}
	}
}



/*****************************************************************************
Function:
  void _DHCPReceive(void)

Description:
  Receives and parses a DHCP message.
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
